spel-uchile/S2_S3_PS_MAG_PCBs/Grafeno V2/TG_SAT_24V0_V1.4-BOM.xlsx

 |  |  | TG_DEV-24V0-V1.4 PCS BOM
Item # | *Designator | *Qty | Manufacturer | *Mfg Part # | Description / Value | *Package/Footprint | Type | Your Instructions / Notes
1 | C7 | 1 | Taiyo Yuden | UMF107B7223KAHT | Capacitor, 0,022 uF, +/- 10%, 50V, X7R | 0603 | SMD
2 | C6 | 1 | Yageo | CC0603KRX7R8BB104 | Capacitor, 0,1 uF, +/- 10%, 25V, X7R | 0603 | SMD
3 | J3 | 1 | Molex | 532610841 | Connector 4 ways |  | SMD
4 | J9 | 1 | Molex | 532610871 | Connector 8 ways |  | SMD
5 | R30 | 1 | Yageo | RT0603BRC0710KL | Resistor, 10 kOhm, +/- 0.1%, 0.1W, +/- 15ppm/C° | 0603 | SMD
6 | RFB2 | 1 | Susumu | RG2012N-124-W-T1 | Resistor, 120 kOhm, +/- 0.05%, 0.125W, +/- 10 ppm/C | 0805 | SMD
7 | RG1 | 1 | Panasonic | ERA-8ARW1432V | Resistor, 14,3 kOhm, +/- 0.05%, 0.25W, +/- 10 ppm/C | 1206 | SMD
8 | RG2 | 1 | Panasonic | ERA-8ARW163V | Resistor, 16 kOhm, +/- 0.05%, 0.25W, +/- 10 ppm/C | 1206 | SMD
9 | RFB1 | 1 | KOA Speer | RN73H1JTTD1722B25 | Resistor, 17,2 kOhm, +/- 0.1%, 0.1W, +/-25 ppm/C° | 0603 | SMD
10 | R32 | 1 | Panasonic | ERA-3VRW1802V | Resistor, 18 kOhm, +/-0.05%, 0.1W, +/-10ppm/C° | 0603 | SMD
11 | C15 | 1 | Taiyo Yuden | UMK316B7225MLHT | Capacitor, 2,2 uF, +/-20%, 50V, Low ESR | 1206 | SMD
12 | R33 | 1 | Stackpole | RNCF0603TKY200R | Resistor, 200 Ohm, +/- 0.01%, 0.1W, +/-5 ppm/C° | 0603 | SMD
13 | C16 | 1 | TDK | C3216X5R1V226M160AC | Capacitor, 22 uF, +/- 20%, 35V, X5R | 1206 | SMD
14 | R34 | 1 | Panasonic | ERA-3ARW362V | Resistor, 3,6 kOhm, +/-0.05%, 0.1W, +/-10ppm/C° | 0603 | SMD
15 | R9 | 1 | Panasonic | ERA-3ARW432V | Resistor, 4,3 kOhm, +/- 0.05%, 0.25W, +/- 10 ppm/C | 0603 | SMD
16 | R29 | 1 | Vishay Thin film | PTN0805E9002BST1 | Resistor, 90 kOhm, +/. 0.1%, 0,2W, +/- 25ppm/C° | 0805 | SMD
17 | U3 | 1 | Analog Devices | ADA4522-1ARMZ | Opamp, , Zero-Drift opamp | 8-MSOP | SMD
18 | U2 | 1 | Texas Instruments | DAC7562SDGST | DAC, , 12 bit, 2 channels | 10VSSOP | SMD
19 | U4 | 1 | Maxim Integrated | MAX6175AASA+ | Voltage ref, 5 Volts, 30 mA, ± 0.06%, 3pm/C° | 8-SOIC | SMD
20 | U1 | 1 | CUI Inc | PES1-S5-D24-M-TR | DC-DC Converter, , +24/-24 V, 1W | 8-SMD | SMD
21 | U12 | 1 | Texas Instruments | REF5025IDR | Voltage reference, 2,5 Volts, +/- 0.05%, 10mA, 3 ppm/C° | 8-SOIC | SMD
22 | C21, C38 | 2 | Murata Electronics | GRM188R61E106KA73J | Capacitor, 10 uF, +/- 10%, 25V, X5R | 0603 | SMD
23 | U16, U17 | 2 | Microchip Technology | 24LC1025T-E/SN | EEPROM, 1 Mbit, 1 Mbit, I2C | SOIC-8 | SMD
24 | C1, C5 | 2 | Taiyo Yuden | UMK316ABJ475MLHT | Capacitor, 4,7 uF, +/- 20%, 50V, X5R, Ultra Low ESR | 1206 | SMD
25 | U6, U15 | 2 | Texas Instruments | ADS7951QDBTRQ1 | Analog to Digital Conv, , 12 bit, SAR, 8 input | 30-TSSOP | SMD
26 | R20, R23, R24 | 3 | TE Connectivity | CRGCQ0603J47R | Resistor, 47 Ohm, 5%, 0.1W | 0603 | SMD
27 | U8, U10, U11 | 3 | Texas Instruments | TMP175AQDRQ1 | Temp sensor, , 12 bits | SOIC-8 | SMD
28 | C22, C26, C27, C28 | 4 | Yageo | CC0603FRNPO9BN151 | Capacitor, 150 pF, +/-1%, 50V | 0603 | SMD | DNP/DNI
29 | R39, R40, R41, R42 | 4 | Yageo | RT0603DRD072K74L | Resistor, 2,74 kOhm, +/- 0.5%, 0.1W, +/- 25ppm/C° | 0603 | SMD | DNP/DNI
30 | C8, C9, C12, C10, C23, C25, C39, C44 | 8 | DNP/DNI | DNP/DNI | DNP/DNI | DNP/DNI | DNP/DNI | DNP/DNI
31 | R6, R12, R36, R46, R50 | 5 | Panasonic | ERA-3AEB332V | Resistor, 3,3 kOhm, +/- 0.1%, 0.1W, +/-25ppm/C° | 0603 | SMD
32 | R5, R11, R35, R45, R49 | 5 | KOA Speer | RN732BTTD3203B25 | Resistor, 320 kOhm, +/- 0.1%, 0.125W, +/-25ppm/C° | 1206 | SMD
33 | R4, R8, R31, R38, R48 | 5 | Vishay | PAT0603E4000BST1 | Resistor SHUNT, 400 Ohm, +/- 0.1%, 0.15W, +/-25ppm/C° | 0603 | SMD
34 | U5, U7, U14, U18, U19 | 5 | Texas Instruments | OPA189IDBVR | Opamp, , Zero drift, Rail-to-rail | SOT23-5 | SMD
35 | C4, C11, C24, C36, C37, C43 | 6 | Taiyo Yuden | LMK212SD104KG-T | Capacitor, 0,1 uF, Low ESR, ± 10%, 10V | 0805 | SMD
36 | R1, R3, R10, R21, R22, R25, R26 | 7 | Stackpole | RNCP0805FTD10K0 | Resistor, 10 kOhm, +/- 1%, 0.25W, +/- 100ppm/C° | 0805 | SMD
37 | C2, C3, C33, C34, C35, C40, C41, C42 | 8 | Taiyo Yuden | GMK107BJ105MAHT | Capacitor, 1 uF, +/-20%, 35V, Low ESR | 0603 | SMD
38 | R2, R7, R13, R37, R47, R51, R14, R15, R27, R28 | 10 | Yageo | RC0603JR-070RL | Resistor, 0 Ohm, 1/10 W | 0603 | SMD
