spel-uchile/S2_S3_PS_MAG_PCBs/CADs/IGEs/PBES2_v4.igs

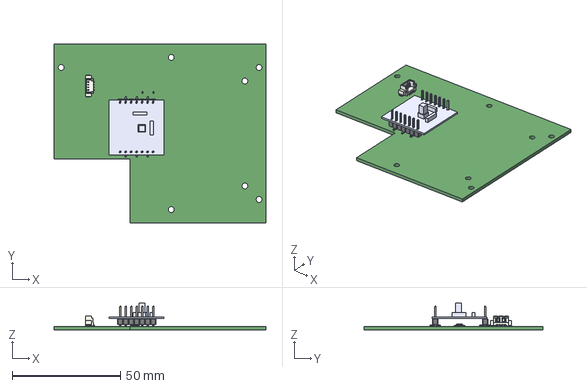
[picture p1: CAD file, 2022-08-22]
CADs/IGEs/PBES2_v4.igs
98.0 x 82.6 x 12.2 mm
