spel-uchile/S2_S3_PS_MAG_PCBs/CADs/Panel B I S3.step

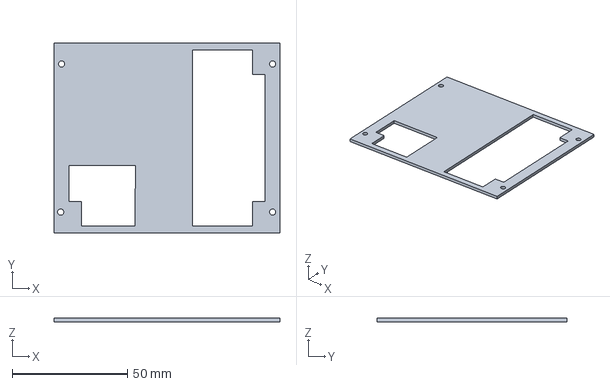
[picture p2: CAD file, 2022-08-22]
CADs/Panel B I S3.step
98.0 x 82.6 x 1.60 mm
