spel-uchile/S2_S3_PS_MAG_PCBs/mini_sensor/MAG_Plus/Panel A E S2.step

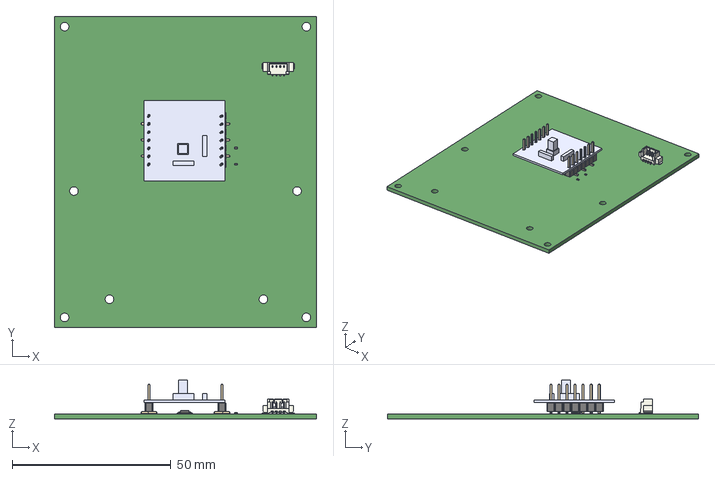
[picture p3: CAD file, 2022-08-22]
mini_sensor/MAG_Plus/Panel A E S2.step
82.6 x 98.0 x 12.2 mm
