spel-uchile/S2_S3_PS_MAG_PCBs/PAD/MAG_Plus/Panel A I S2.step

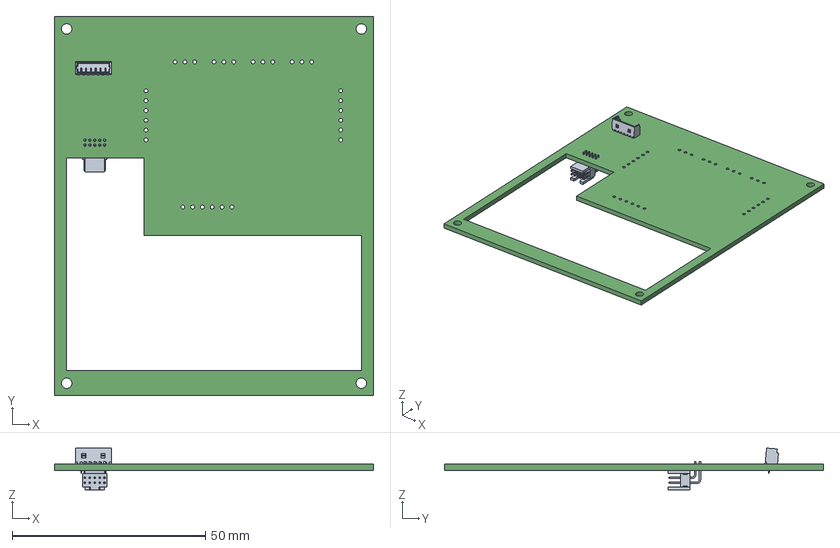
[picture p4: CAD file, 2022-08-22]
PAD/MAG_Plus/Panel A I S2.step
82.6 x 98.0 x 10.9 mm
