spel-uchile/S2_S3_PS_MAG_PCBs/panel test/MAG_Plus/MAG_mini.step

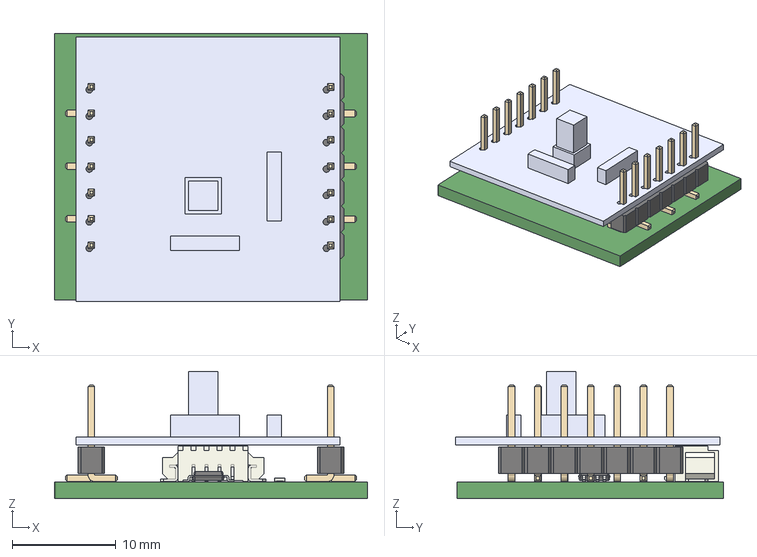
[picture p5: CAD file, 2022-08-22]
panel test/MAG_Plus/MAG_mini.step
30.1 x 25.7 x 12.2 mm
