spel-uchile/S2_S3_PS_MAG_PCBs/PC104 - plansat/MAG_plus/PC104_mini_chamber.dxf

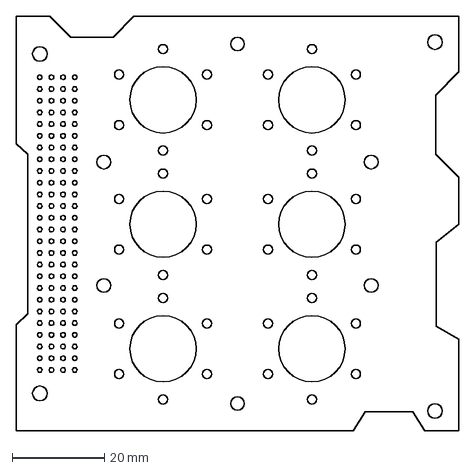
[picture p6: CAD file, 2022-08-22]
PC104 - plansat/MAG_plus/PC104_mini_chamber.dxf
96.0 x 89.9 mm
