spel-uchile/S2_S3_PS_MAG_PCBs/(list of files, cad)

Other CAD files:
Panel A E S3/MAG_Plus/Panel A E S3.step
Panel A I S3/MAG_Plus/Panel A I S3.step
Panel B E S2/MAG_Plus/Panel B E S2.step
Panel B E S3 - plantsat/MAG_Plus/Panel B E S3.step
Panel B E S3/MAG_Plus/Panel B E S3.step
Panel B I S2/MAG_Plus/Panel B I S2.step
Panel B I S3 PC/MAG_Plus/Panel B I S3.step
Panel B I S3/MAG_Plus/Panel B I S3.step
PBD/MAG_Plus/Panel B I S2.step
CADs/IGEs/PBES2.igs
CADs/Panel B E S2.step
CADs/IGEs/PAES2_v3.igs
CADs/Panel A E S2.step
CADs/IGEs/PBIS3.igs
CADs/Panel B E S3.step
CADs/IGEs/PAIS3.igs
CADs/Panel A E S3.step
CADs/IGEs/PBES3.igs
CADs/Panel A I S3.step
CADs/IGEs/PAES2.igs
CADs/IGEs/PAIS2.igs
CADs/IGEs/PBES3_v2.igs
CADs/IGEs/PAES3.igs
CADs/IGEs/PBIS2_v2.igs
CADs/IGEs/PBIS3_v2.igs
CADs/IGEs/PBIS2.igs
CADs/IGEs/PAES2_v2.igs
CADs/IGEs/PBES2_v2.igs
CADs/IGEs/PBES2_v3.igs
