spel-uchile/S2_S3_PS_MAG_PCBs/PC104 main/MAG_Plus/MAG_Plus.kicad_pcb

## KiCad design PC104 main/MAG_Plus/MAG_Plus.kicad_pcb (2022-08-22)

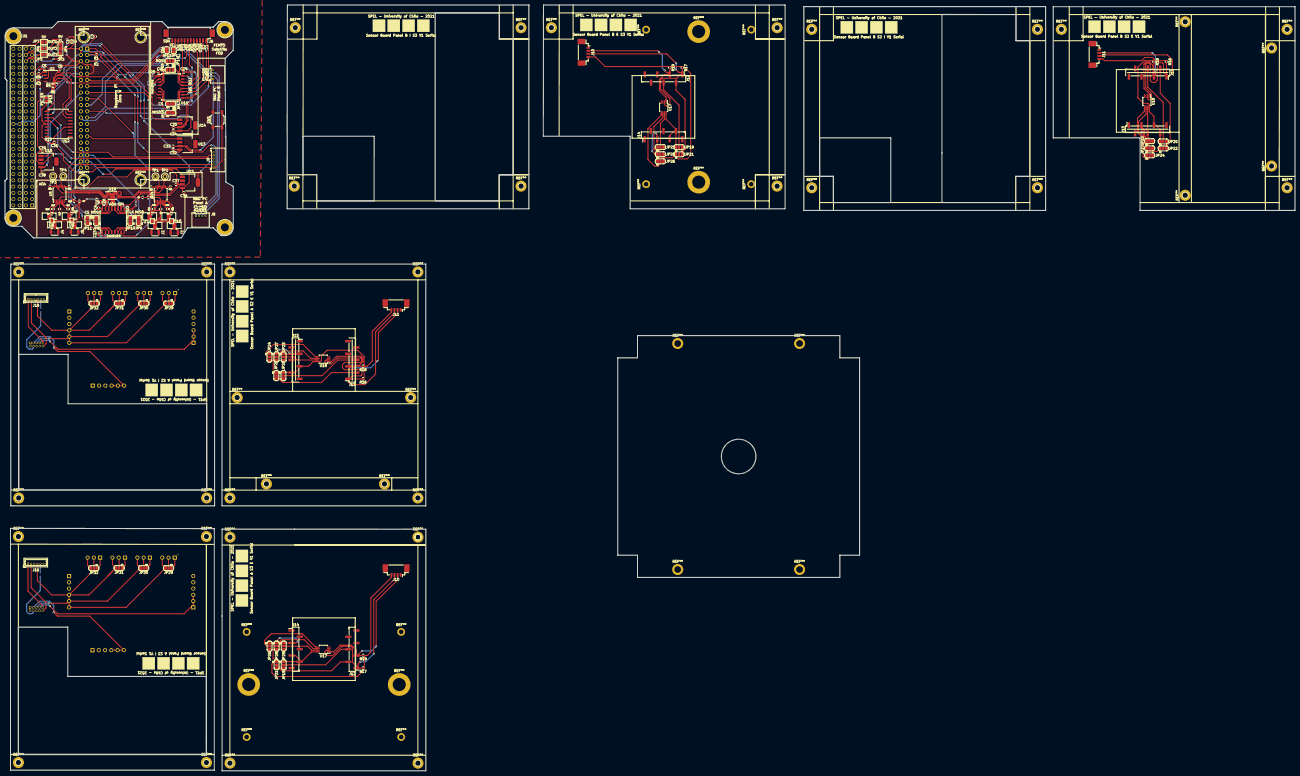
[picture p12: board PC104 main/MAG_Plus/MAG_Plus.kicad_pcb from above]

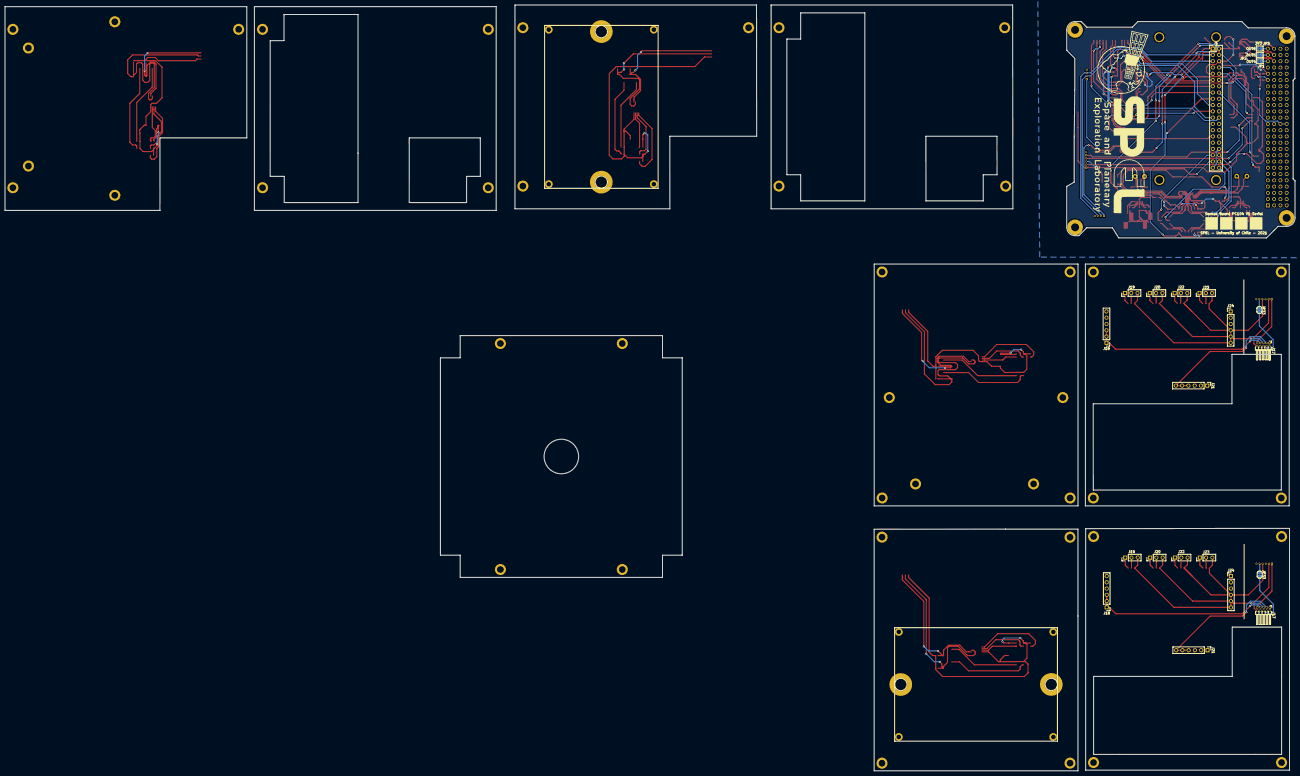
[picture p13: board PC104 main/MAG_Plus/MAG_Plus.kicad_pcb from below]

Board: 2 copper layers, 522.8 x 310.4 mm, 169 parts (22 on the bottom side), 123 nets.

Parts:
C1, C2, C3, C4, C5, C6, C23, C24, C25, C26, C27, C31, C32, C33, C34, C35, C36, C37, C38, C39: C; C_0402
C7, C8, C9, C10, C11, C12, C13, C14, C15, C16, C17, C18, C19, C20, C21, C22: C_Small; C_0402
J1: RPi_GPIO; Pin_Header_Straight_2x20_Pitch2.54mm
J2, J3, J4, J5: U.FL-R-SMT(01); U.FL_Hirose_U.FL-R-SMT-1_Vertical
J6: Conn_01x12_Male; Molex_PicoBlade_53261-1271_12x1.25mm_Angled
J7, J8: Conn_01x04_Male; Molex_PicoBlade_53048-0410_04x1.25mm_Angled
J9: Conn_01x06_Male; Molex_PicoBlade_53048-0610_06x1.25mm_Angled
J10, J10#2, J11, J11#2: Conn_01x04_Male; Molex_PicoBlade_53398-0471_04x1.25mm_Straight
J12, J12#2, J14, J14#2: Conn_01x07_Female; Pin_Header_Straight_1x07_Pitch2.54mm_SMD_Pin1Left
J13, J13#2, J15, J15#2: Conn_01x07_Female; Pin_Header_Straight_1x07_Pitch2.54mm_SMD_Pin1Right
J16, J16#2: Conn_01x06_Male; Molex_PicoBlade_53047-0610_06x1.25mm_Straight
J17, J17#2: Conn_02x05_Counter_Clockwise; Pin_Header_Angled_2x05_Pitch1.27mm
J18, J18#2, J21, J21#2, J24, J24#2: Conn_01x06_Male; Pin_Header_Straight_1x06_Pitch2.54mm
J19, J19#2, J20, J20#2, J22, J22#2, J23, J23#2: Conn_01x03_Male; Pin_Header_Straight_1x03_Pitch2.54mm
JP1, JP2, JP3, JP5, JP6, JP7: Jumper_2_Open; SolderJumper-2_P1.3mm_Open_TrianglePad1.0x1.5mm
JP4: Jumper_3_Open; SolderJumper-3_P2.0mm_Open_TrianglePad1.0x1.5mm_NumberLabels
JP8, JP9, JP10, JP11, JP14, JP15, JP16, JP17, JP19, JP19#2, JP20, JP20#2, JP21, JP21#2, JP22, JP22#2, JP23, JP23#2, JP24, JP24#2, JP25, JP25#2, JP26, JP26#2, JP27, JP27#2, JP28, JP28#2, JP29, JP29#2, JP30, JP30#2, JP31, JP31#2, JP32, JP32#2: Jumper_3_Open; SolderJumper-3_P1.3mm_Open_RoundedPad1.0x1.5mm
JP12, JP13, JP33, JP33#2: Jumper_2_Open; SolderJumper-2_P1.3mm_Open_RoundedPad1.0x1.5mm
JP18: Jumper_2_Open; SolderJumper-2_P1.3mm_Open_Pad1.0x1.5mm
R1, R2, R3, R4, R5, R6, R15, R16, R16#2, R17, R17#2, R18, R18#2, R19, R19#2: R; R_0402
R7, R8, R9, R10, R11, R13: R_Small; R_0402
SW1: SW_Push; SW_SPST_SKQG
TP1, TP2, TP3, TP4: TestPoint; Test_Point_Keystone_5000-5004_Miniature
U1: Payload; PC104-Standard
U2: ISO1540; SOIC-8_3.9x4.9mm_Pitch1.27mm
U3, U11: ISO7341C; SOIC-16W_7.5x10.3mm_Pitch1.27mm
U4, U5: AD8302; TSSOP-14_4.4x5mm_Pitch0.65mm
U7, U8, U9, U10: QPQ1906SR
U12: PIC16F1847-I_SO; SOIC-18W_7.5x11.6mm_Pitch1.27mm
U13, U14, U16: LP38693MP-3.3; SOT-223-5
U15: LP38693MP-5.0; SOT-223-5
U17, U17#2, U18, U18#2: MCP9804_MSOP; MSOP-8_3x3mm_Pitch0.65mm
U19: ADC084S051; MSOP-10_3x3mm_Pitch0.5mm

Connections:
3V3IN: JP1.2, JP2.2, JP3.2, JP4.1
5VIN: JP4.3, JP5.2, JP6.2, JP7.2
ANT1_IN: J2.1, U7.1
ANT1_OUT: C11.1, R7.1, U7.2
ANT2_IN: J3.1, U10.1
ANT2_OUT: C14.1, R8.2, U10.2
ANT3_IN: J4.1, U8.1
ANT3_OUT: C15.1, R9.1, U8.2
ANT4_IN: J5.1, U9.1
ANT4_OUT: C18.1, R10.2, U9.2
AOA_5V: C4.1, C7.2, C9.2, C26.1, C27.1, C37.1, R11.1, R13.1, U3.10, U3.16, U15.3, U19.2
AOA_CLK: JP10.3, U3.12, U19.10
AOA_EN: J1.37, U15.1
AOA_MISO: JP9.3, U3.11, U19.9
AOA_MOSI: JP8.3, U3.13, U19.8
AOA_SS: JP11.3, U3.14, U19.1
CLK0: J1.23, JP16.2
CLK1: J1.40, JP10.2
CSP_SCL: R4.2, U1.43, U2.3
CSP_SDA: R3.2, U1.41, U2.2
ENN: J20.2, J20#2.2, JP30.2, JP30#2.2
ENP: J23.2, J23#2.2, JP32.2, JP32#2.2
FOD_3V3: C24.1, C35.1, J6.7, J6.10, U11.10, U11.16, U14.3
FOD_CC: J1.15, J6.1
FOD_CS: J6.2, JP17.3, U11.12
FOD_DPL: J1.11, J6.8
FOD_EN: J1.13, U14.1
FOD_MISO: J6.3, JP15.3, U11.11
FOD_MOSI: J6.5, JP14.3, U11.14
FOD_SCK: J6.4, JP16.3, U11.13
FOD_SCL: J6.11, JP12.2
FOD_SDA: J6.12, JP13.2
GND: C1.2, C2.2, C3.2, C4.2, C5.2, C6.2, C7.1, C8.1, C9.1, C10.1, C12.1, C13.1, C16.1, C17.1, C19.2, C20.2, C21.2, C22.2, C23.2, C24.2, C25.2, C26.2, C27.2, C31.1, C32.2, C33.2, C34.2, C35.2, C36.2, C37.2, C38.2, C39.2, J1.6, J1.9, J1.14, J1.20, J1.25, J1.30, J1.34, J1.39, J2.2, J3.2, J4.2, J5.2, J6.6, J6.9, J7.4, J8.4, J9.3, J10.1, J10#2.1, J11.1, J11#2.1, J12.7, J12#2.7, J13.7, J13#2.7, J14.7, J14#2.7, J15.7, J15#2.7, J16.3, J16#2.3, J17.6, J17#2.6, J18.4, J18.5, J18.6, J18#2.4, J18#2.5, J18#2.6, J19.1, J19#2.1, J20.1, J20#2.1, J21.1, J21.2, J21.3, J21#2.1, J21#2.2, J21#2.3, J22.1, J22#2.1, J23.1, J23#2.1, J24.1, J24.2, J24.3, J24#2.1, J24#2.2, J24#2.3, JP19.3, JP19#2.3, JP20.3, JP20#2.3, JP21.3, JP21#2.3, JP22.3, JP22#2.3, JP23.3, JP23#2.3, JP24.3, JP24#2.3, JP25.3, JP25#2.3, JP26.3, JP26#2.3, JP27.3, JP27#2.3, JP28.3, JP28#2.3, JP29.1, JP29#2.1, JP30.1, JP30#2.1, JP31.1, JP31#2.1, JP32.1, JP32#2.1, R7.2, R8.1, R9.2, R10.1, SW1.1, U2.4, U2.5, U3.2, U3.8, U3.9, U3.15, U4.1, U4.7, U5.1, U5.7, U7.3, U8.3, U9.3, U10.3, U11.2, U11.8, U11.9, U11.15, U12.5, U13.5, U14.5, U15.5, U16.5, U17.4, U17#2.4, U18.4, U18#2.4, U19.3
ICSPCLK: J9.5, U12.12
ICSPDAT: J9.4, U12.13
LPS_3V3: J16.5, J16#2.5, JP33.1, JP33#2.1
LPS_3V3J: J17.4, J17#2.4, JP33.2, JP33#2.2
LPS_5V: J16.4, J16#2.4, J17.5, J17#2.5, J19.3, J19#2.3, J20.3, J20#2.3, J22.3, J22#2.3, J23.3, J23#2.3, J24.4, J24.5, J24.6, J24#2.4, J24#2.5, J24#2.6, JP29.3, JP29#2.3, JP30.3, JP30#2.3, JP31.3, JP31#2.3, JP32.3, JP32#2.3
LPS_RX: J16.1, J16#2.1, J17.9, J17#2.9
LPS_TX: J16.2, J16#2.2, J17.10, J17#2.10
MAG1_A0: JP25.2, JP25#2.2, U17.7, U17#2.7
MAG1_A1: JP28.2, JP28#2.2, U17.6, U17#2.6
MAG1_A2: JP26.2, JP26#2.2, U17.5, U17#2.5
MAG1_BIT0: J12.4, J12#2.4, JP19.2, JP19#2.2
MAG1_BIT1: J12.2, J12#2.2, JP21.2, JP21#2.2
MAG2_A0: JP23.2, JP23#2.2, U18.7, U18#2.7
MAG2_A1: JP27.2, JP27#2.2, U18.6, U18#2.6
MAG2_A2: JP24.2, JP24#2.2, U18.5, U18#2.5
MAG2_BIT0: J13.4, J13#2.4, JP20.2, JP20#2.2
MAG2_BIT1: J13.2, J13#2.2, JP22.2, JP22#2.2
MAG_3V3: C33.1, J7.1, J8.1, J10.4, J10#2.4, J11.4, J11#2.4, J14.3, J14.5, J14.6, J14#2.3, J14#2.5, J14#2.6, J15.3, J15.5, J15.6, J15#2.3, J15#2.5, J15#2.6, JP19.1, JP19#2.1, JP20.1, JP20#2.1, JP21.1, JP21#2.1, JP22.1, JP22#2.1, JP23.1, JP23#2.1, JP24.1, JP24#2.1, JP25.1, JP25#2.1, JP26.1, JP26#2.1, JP27.1, JP27#2.1, JP28.1, JP28#2.1, R16.1, R16#2.1, R17.1, R17#2.1, R18.1, R18#2.1, R19.1, R19#2.1, U13.3, U17.8, U17#2.8, U18.8, U18#2.8
MAG_EN: J1.29, U13.1
MCLR: C31.2, J9.1, R15.2, SW1.2, U12.4
MISO0: J1.21, JP15.2
MISO1: J1.35, JP9.2
MOSI0: J1.19, JP14.2
MOSI1: J1.38, JP8.2
unnamed: C8.2, R11.2, U4.4
unnamed: C10.2, R13.2, U5.4
unnamed: C11.2, U4.2
unnamed: C12.2, U4.3
unnamed: C13.2, U4.5
unnamed: C14.2, U4.6
unnamed: C15.2, U5.2
unnamed: C16.2, U5.3
unnamed: C17.2, U5.5
unnamed: C18.2, U5.6
unnamed: C19.1, U4.14
unnamed: C20.1, U4.8
unnamed: C21.1, U5.14
unnamed: C22.1, U5.8
unnamed: J12.5, J12#2.5
unnamed: J12.6, J12#2.6
unnamed: J13.5, J13#2.5
unnamed: J13.6, J13#2.6
unnamed: J14.1, J14#2.1
unnamed: J14.2, J14#2.2
unnamed: J14.4, J14#2.4
unnamed: J15.1, J15#2.1
unnamed: J15.2, J15#2.2
unnamed: J15.4, J15#2.4
unnamed: J16.6, J16#2.6
unnamed: J17.1, J17#2.1
unnamed: J17.2, J17#2.2
unnamed: J17.8, J17#2.8
unnamed: U17.3, U17#2.3
unnamed: U18.3, U18#2.3
OUT1_3V3: JP1.1, U1.47
OUT2_3V3: JP2.1, U1.49
OUT3_3V3: JP3.1, U1.51
OUT4_5V0: JP5.1, U1.48
OUT5_5V0: JP6.1, U1.50
OUT6_5V0: JP7.1, U1.52
PIC_3V3: C39.1, J9.2, JP18.1, U16.3
PIC_3V3J: C6.1, JP18.2, R5.1, R6.1, R15.1, U2.8, U12.14
PIC_EN: J1.16, U16.1
PIC_SCL: JP12.1, R6.2, U2.6, U12.10
PIC_SDA: JP13.1, R5.2, U2.7, U12.7
PSN: J19.2, J19#2.2, JP29.2, JP29#2.2
PSP: J22.2, J22#2.2, JP31.2, JP31#2.2
RPI_3V3: C3.1, C23.1, C25.1, J1.1, J1.17, R1.1, R2.1, U3.1, U3.7, U11.1, U11.7
RPI_RX: J1.10, U12.11
RPI_SCL: J1.5, J7.2, J8.2, J10.3, J10#2.3, J11.3, J11#2.3, J12.1, J12#2.1, J13.1, J13#2.1, R2.2, R16.2, R16#2.2, R17.2, R17#2.2, U17.2, U17#2.2, U18.2, U18#2.2
RPI_SDA: J1.3, J7.3, J8.3, J10.2, J10#2.2, J11.2, J11#2.2, J12.3, J12#2.3, J13.3, J13#2.3, R1.2, R18.2, R18#2.2, R19.2, R19#2.2, U17.1, U17#2.1, U18.1, U18#2.1
RPI_TX: J1.8, U12.8
SAT_3V3: C5.1, R3.1, R4.1, U1.79, U1.80, U2.1
SS00: J1.24, JP17.2
SS10: J1.36, JP11.2
VIN: C1.1, C2.1, C32.1, C34.1, C36.1, C38.1, J1.2, J1.4, JP4.2, U13.4, U14.4, U15.4, U16.4
VMAG1: TP1.1, U4.12, U4.13, U19.7
VMAG2: TP3.1, U5.12, U5.13, U19.5
VNEG: J17.7, J17#2.7, J18.1, J18.2, J18.3, J18#2.1, J18#2.2, J18#2.3
VPHS1: TP2.1, U4.9, U4.10, U19.6
VPHS2: TP4.1, U5.9, U5.10, U19.4
VPOS: J17.3, J17#2.3, J21.4, J21.5, J21.6, J21#2.4, J21#2.5, J21#2.6
iaRPI_CLK: JP10.1, U3.5
iaRPI_MISO: JP9.1, U3.6
iaRPI_MOSI: JP8.1, U3.4
iaRPI_SS0: JP11.1, U3.3
ifRPI_CLK: JP16.1, U11.4
ifRPI_MISO: JP15.1, U11.6
ifRPI_MOSI: JP14.1, U11.3
ifRPI_SS0: JP17.1, U11.5
