spel-uchile/S2_S3_PS_MAG_PCBs/Panel B E S3/MAG_Plus/MAG_Plus.kicad_pcb

## KiCad design Panel B E S3/MAG_Plus/MAG_Plus.kicad_pcb (2022-08-22)

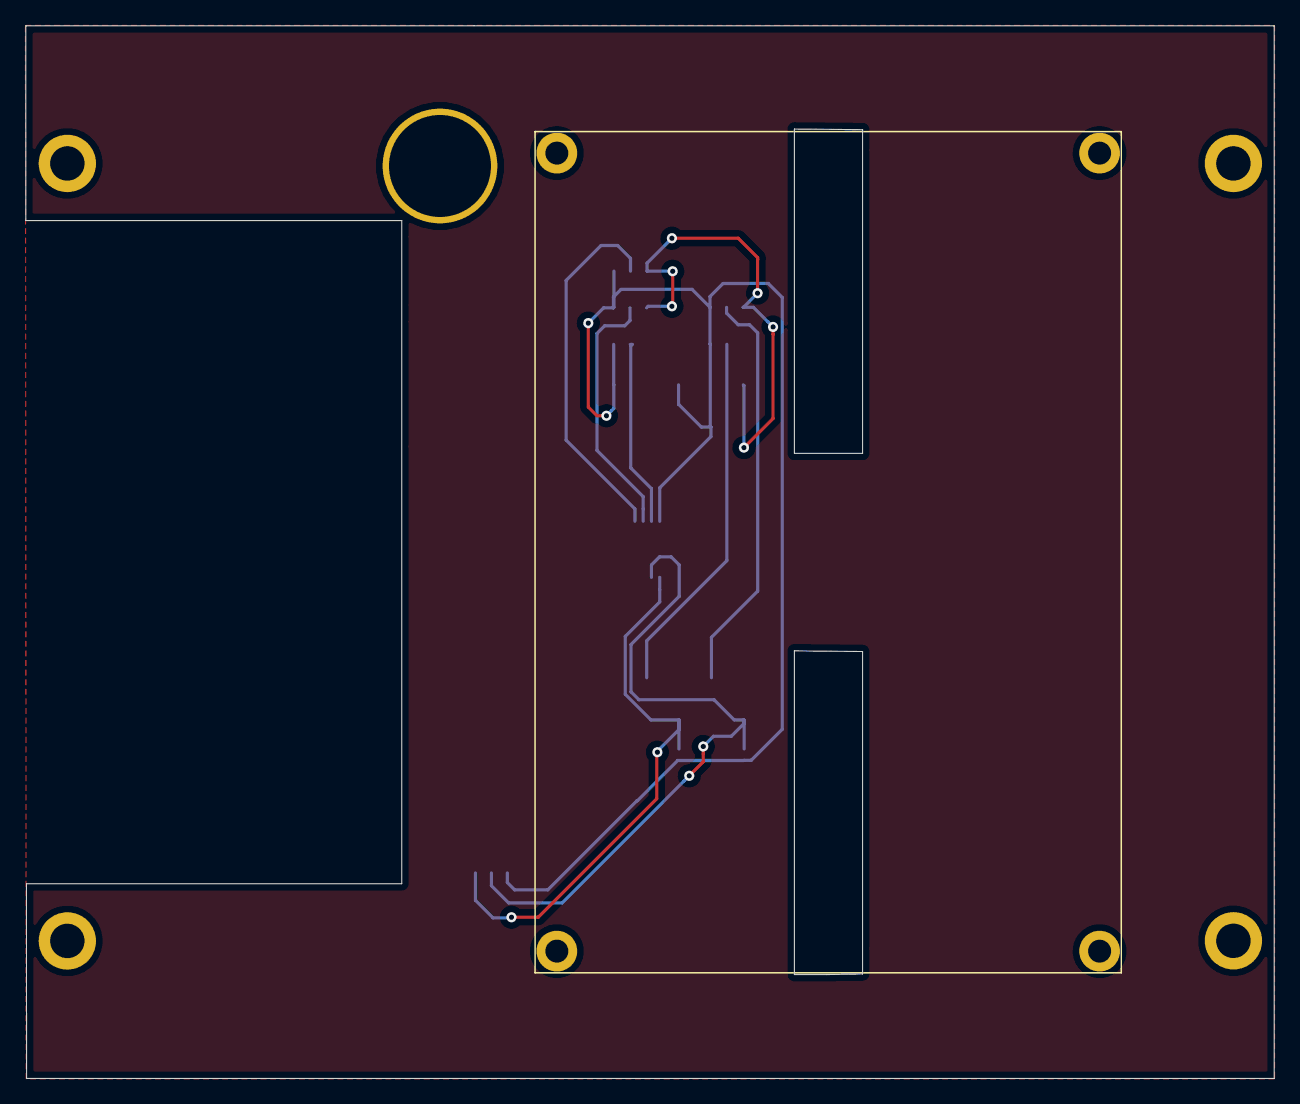
[picture p14: board Panel B E S3/MAG_Plus/MAG_Plus.kicad_pcb from above]

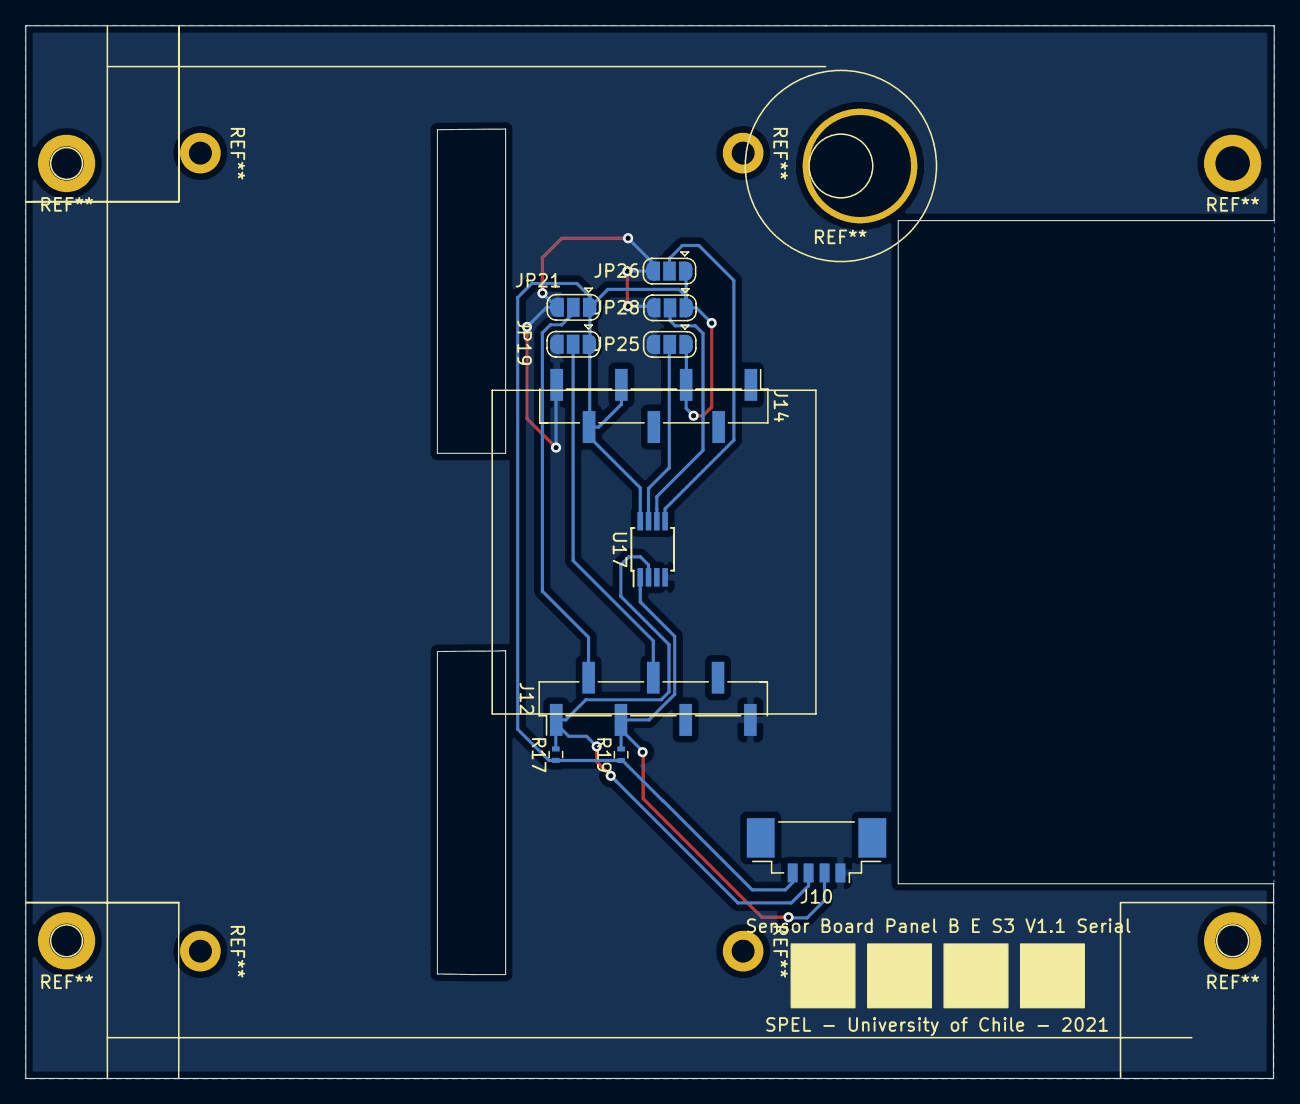
[picture p15: board Panel B E S3/MAG_Plus/MAG_Plus.kicad_pcb from below]

Board: 2 copper layers, 98.0 x 82.6 mm, 11 parts (11 on the bottom side), 9 nets.

Parts:
J10: Conn_01x04_Male; Molex_PicoBlade_53398-0471_04x1.25mm_Straight
J12, J14: Conn_01x07_Female; Pin_Header_Straight_1x07_Pitch2.54mm_SMD_Pin1Left
JP19, JP21, JP25, JP26, JP28: Jumper_3_Open; SolderJumper-3_P1.3mm_Open_RoundedPad1.0x1.5mm
R17, R19: R; R_0402
U17: MCP9804_MSOP; MSOP-8_3x3mm_Pitch0.65mm

Connections:
GND: J10.1, J12.7, J14.7, JP19.3, JP21.3, JP25.3, JP26.3, JP28.3, U17.4
MAG1_A0: JP25.2, U17.7
MAG1_A1: JP28.2, U17.6
MAG1_A2: JP26.2, U17.5
MAG1_BIT0: J12.4, JP19.2
MAG1_BIT1: J12.2, JP21.2
MAG_3V3: J10.4, J14.3, J14.5, J14.6, JP19.1, JP21.1, JP25.1, JP26.1, JP28.1, R17.1, R19.1, U17.8
RPI_SCL: J10.3, J12.1, R17.2, U17.2
RPI_SDA: J10.2, J12.3, R19.2, U17.1
