spel-uchile/S2_S3_PS_MAG_PCBs/PC104 _V3P2/MAG_Plus/MAG_Plus.kicad_pcb

## KiCad design PC104 _V3P2/MAG_Plus/MAG_Plus.kicad_pcb (2022-08-22)

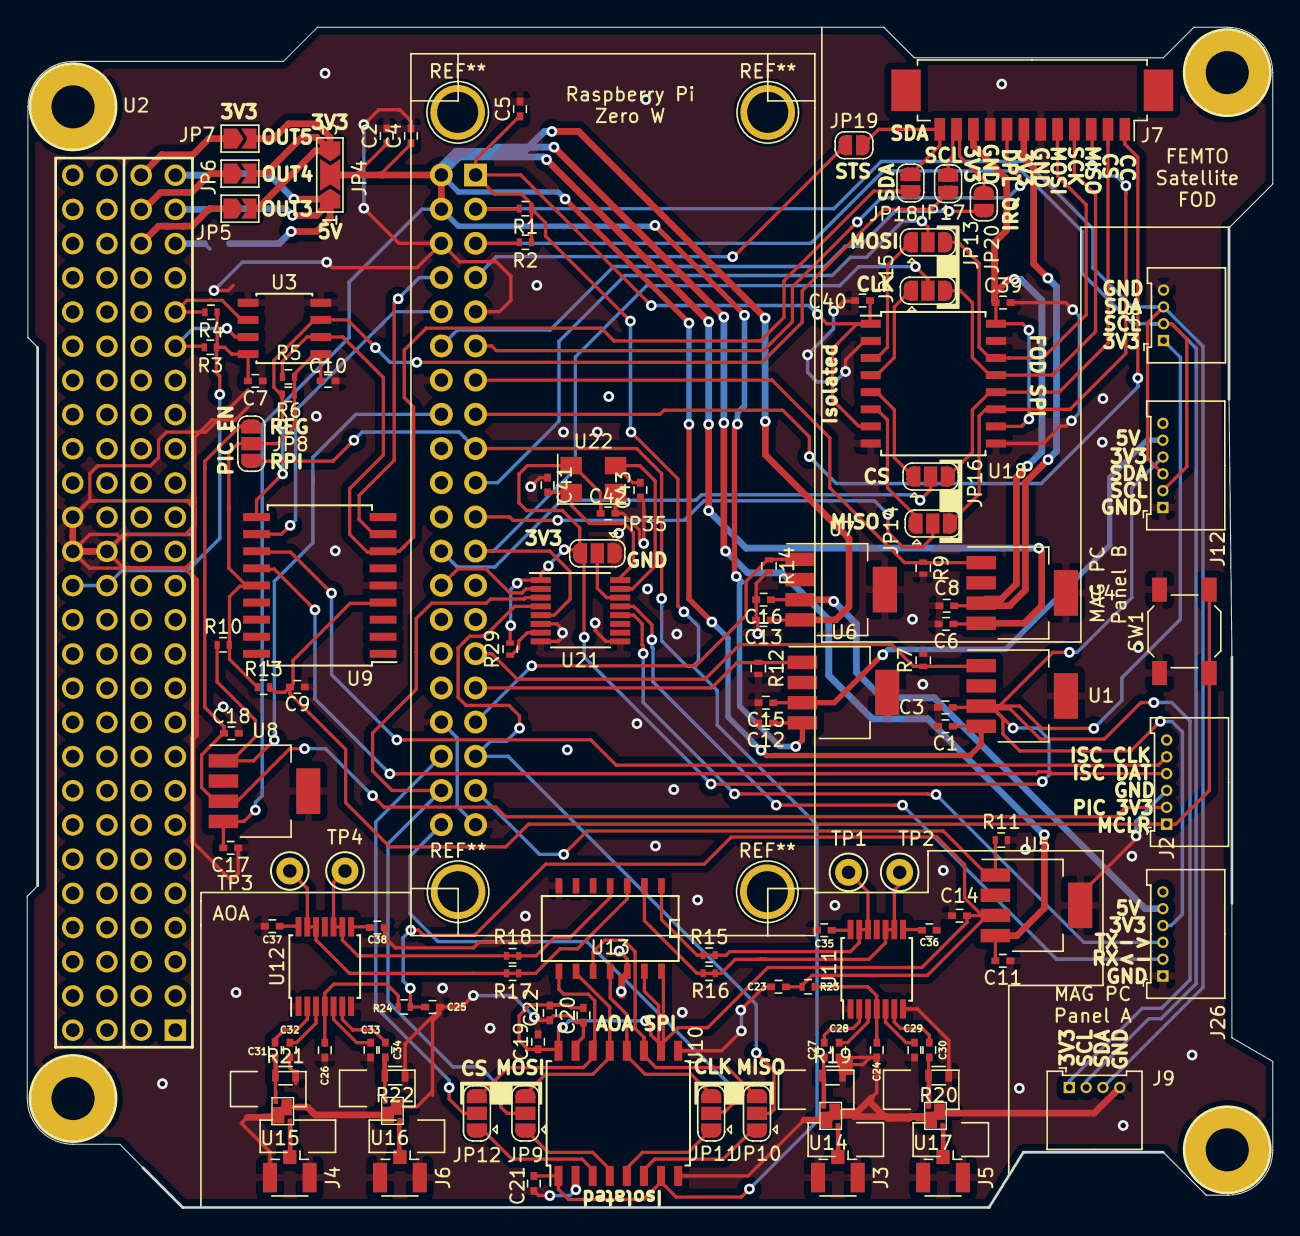
[picture p16: board PC104 _V3P2/MAG_Plus/MAG_Plus.kicad_pcb from above]

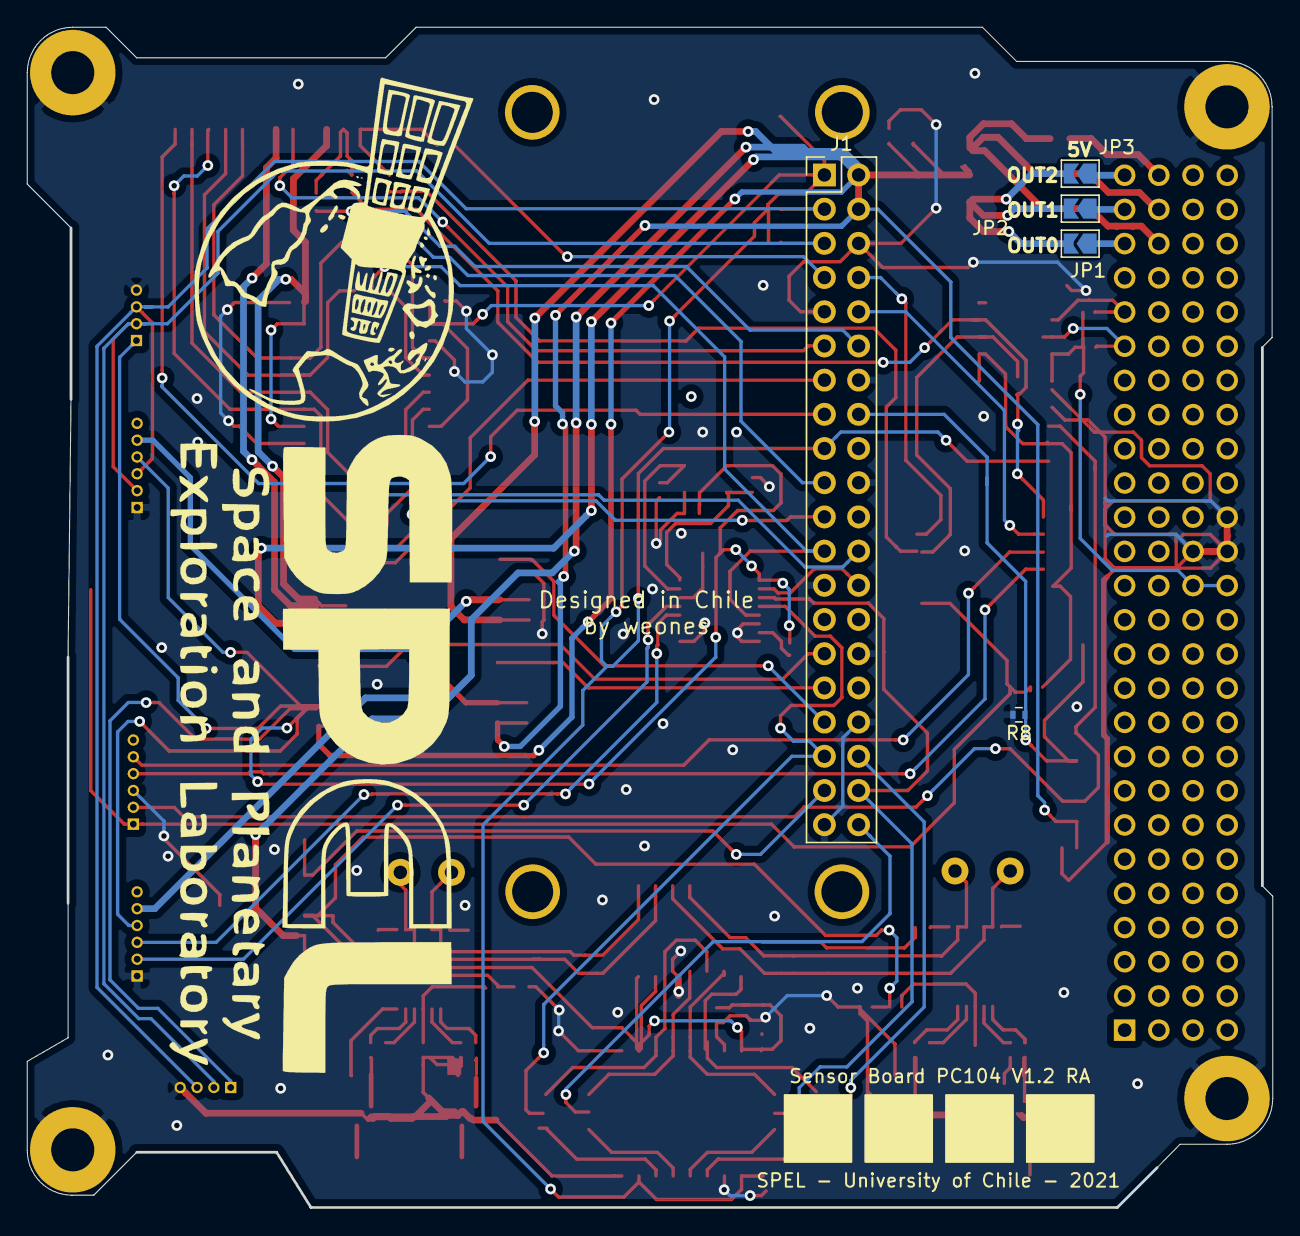
[picture p17: board PC104 _V3P2/MAG_Plus/MAG_Plus.kicad_pcb from below]

Board: 2 copper layers, 92.5 x 87.7 mm, 125 parts (5 on the bottom side), 99 nets.

Parts:
C1, C2, C3, C4, C5, C6, C7, C8, C9, C10, C11, C12, C13, C14, C15, C16, C17, C18, C19, C20, C21, C22, C39, C40, C42: C; C_0402
C23, C24, C25, C26, C27, C28, C29, C30, C31, C32, C33, C34, C35, C36, C37, C38: C_Small; C_0402
C41, C43: 15pF; C_0402
J1: RPi_GPIO; Pin_Header_Straight_2x20_Pitch2.54mm
J2, J12, J26: Conn_01x06_Male; Molex_PicoBlade_53048-0610_06x1.25mm_Angled
J3, J4, J5, J6: U.FL-R-SMT(01); U.FL_Hirose_U.FL-R-SMT-1_Vertical
J7: Conn_01x12_Male; Molex_PicoBlade_53261-1271_12x1.25mm_Angled
J8, J9: Conn_01x04_Male; Molex_PicoBlade_53048-0410_04x1.25mm_Angled
JP1, JP2, JP3, JP5, JP6, JP7: Jumper_2_Open; SolderJumper-2_P1.3mm_Open_TrianglePad1.0x1.5mm
JP4: Jumper_3_Open; SolderJumper-3_P2.0mm_Open_TrianglePad1.0x1.5mm_NumberLabels
JP8, JP9, JP10, JP11, JP12, JP13, JP14, JP15, JP16: Jumper_3_Open; SolderJumper-3_P1.3mm_Open_RoundedPad1.0x1.5mm
JP17, JP18, JP19, JP20: Jumper_2_Open; SolderJumper-2_P1.3mm_Open_RoundedPad1.0x1.5mm
JP35: SolderJumper_3_Open; SolderJumper-3_P1.3mm_Open_RoundedPad1.0x1.5mm
R1, R2, R3, R4, R5, R6, R7, R8, R9, R10, R11, R12, R13, R14, R15, R16, R17, R18, R29: R; R_0402
R19, R20, R21, R22: R_Small; R_0603
R23, R24: R_Small; R_0402
SW1: SW_Push; SW_SPST_SKQG
TP1, TP2, TP3, TP4: TestPoint; Test_Point_Keystone_5000-5004_Miniature
U1, U4, U8: LP38693MP-3.3; SOT-223-5
U2: Payload; PC104-Standard
U3: ISO1540; SOIC-8_3.9x4.9mm_Pitch1.27mm
U5, U6, U7: LP38693MP-5.0; SOT-223-5
U9: PIC16F1847-I_SO; SOIC-18W_7.5x11.6mm_Pitch1.27mm
U10, U18: ISO7341C; SOIC-16W_7.5x10.3mm_Pitch1.27mm
U11, U12: AD8302; TSSOP-14_4.4x5mm_Pitch0.65mm
U13: MCP3204; SOIC-14_N
U14, U15, U16, U17: QPQ1906SR; QPQ1906SR3
U21: SC16IS741AIPWJ; TSSOP-16_4.4x5mm_Pitch0.65mm
U22: Xtal; Crystal_SMD_5032-4pin_5.0x3.2mm

Connections:
3V3IN: JP1.2, JP2.2, JP3.2, JP4.1
5VIN: JP4.3, JP5.2, JP6.2, JP7.2
ANT1_IN: J3.1, U14.1
ANT1_OUT: C27.1, R19.1, U14.2
ANT2_IN: J5.1, U17.1
ANT2_OUT: C30.1, R20.2, U17.2
ANT3_IN: J4.1, U15.1
ANT3_OUT: C31.1, R21.1, U15.2
ANT4_IN: J6.1, U16.1
ANT4_OUT: C34.1, R22.2, U16.2
AOA_5V: C14.1, C19.1, C20.1, C22.1, C23.2, C25.2, R23.1, R24.1, U5.3, U10.10, U10.16, U13.13, U13.14
AOA_CLK: JP11.3, U10.12, U13.11
AOA_EN: J1.37, R11.1, U5.1
AOA_MISO: JP10.3, U10.11, U13.10
AOA_MOSI: JP9.3, U10.13, U13.9
AOA_SS: JP12.3, U10.14, U13.8
CLK0: J1.23, JP15.2, U21.5
CLK1: J1.40, JP11.2
CSP_SCL: R4.2, U2.43, U3.6
CSP_SDA: R3.2, U2.41, U3.7
FOD_3V3: C8.1, C39.1, J7.7, J7.10, U4.3, U18.10, U18.16
FOD_CC: J1.15, J7.1
FOD_CS: J7.2, JP16.3, U18.12
FOD_DPL: J1.11, J7.8
FOD_EN: J1.13, R9.1, U4.1
FOD_IRQ: J1.12, JP20.1
FOD_MISO: J7.3, JP14.3, U18.11
FOD_MOSI: J7.5, JP13.3, U18.14
FOD_SCK: J7.4, JP15.3, U18.13
FOD_SCL: J7.11, JP17.2, JP20.2
FOD_SDA: J7.12, JP18.2, JP19.2
FOD_STS: J1.7, JP19.1
GND: C1.2, C2.2, C3.2, C4.2, C5.2, C6.2, C7.2, C8.2, C9.1, C10.2, C11.2, C12.2, C13.2, C14.2, C15.2, C16.2, C17.2, C18.2, C19.2, C20.2, C21.2, C22.2, C23.1, C24.1, C25.1, C26.1, C28.1, C29.1, C32.1, C33.1, C35.2, C36.2, C37.2, C38.2, C39.2, C40.2, C41.1, C42.2, C43.1, J1.6, J1.9, J1.14, J1.20, J1.25, J1.30, J1.34, J1.39, J2.3, J3.2, J4.2, J5.2, J6.2, J7.6, J7.9, J8.4, J9.4, J12.1, J26.1, JP35.1, R7.2, R8.2, R9.2, R11.2, R12.2, R14.2, R19.2, R20.1, R21.2, R22.1, SW1.1, U1.5, U2.81, U2.82, U2.84, U3.4, U3.5, U4.5, U5.5, U6.5, U7.5, U8.5, U9.5, U10.2, U10.8, U10.9, U10.15, U11.1, U11.7, U12.1, U12.7, U13.7, U13.12, U14.3, U15.3, U16.3, U17.3, U18.2, U18.8, U18.9, U18.15, U21.6, U21.8, U21.9, U22.2
ICSPCLK: J2.5, U9.12
ICSPDAT: J2.4, U9.13
IRQ: R29.1, U21.7
LP_5V: C16.1, J26.5, U7.3
LP_EN: J1.33, R14.1, U7.1
LP_RESET: JP35.2, U21.14
MAG_3V3: C3.1, C42.1, J8.1, J9.1, J12.4, J26.4, JP35.3, R29.2, U1.3, U21.1, U22.4
MAG_EN: J1.29, R7.1, U1.1
MCLR: C9.2, J2.1, R13.2, SW1.2, U9.4
MISO0: J1.21, JP14.2
MISO1: J1.35, JP10.2, U21.4
MOSI0: J1.19, JP13.2
MOSI1: J1.38, JP9.2, U21.3
unnamed: C24.2, R23.2, U11.4
unnamed: C26.2, R24.2, U12.4
unnamed: C27.2, U11.2
unnamed: C28.2, U11.3
unnamed: C29.2, U11.5
unnamed: C30.2, U11.6
unnamed: C31.2, U12.2
unnamed: C32.2, U12.3
unnamed: C33.2, U12.5
unnamed: C34.2, U12.6
unnamed: C35.1, U11.14
unnamed: C36.1, U11.8
unnamed: C37.1, U12.14
unnamed: C38.1, U12.8
OUT1_3V3: JP1.1, U2.47
OUT2_3V3: JP2.1, U2.49
OUT3_3V3: JP3.1, U2.51
OUT4_5V0: JP5.1, U2.48
OUT5_5V0: JP6.1, U2.50
OUT6_5V0: JP7.1, U2.52
PC_5V: C15.1, J12.5, U6.3
PC_EN: J1.31, R12.1, U6.1
PIC_3V3: C18.1, J2.2, JP8.1, U8.3
PIC_3V3J: C10.1, JP8.2, R5.1, R6.1, R10.2, R13.1, U3.1, U9.14
PIC_EN: J1.16, R8.1, R10.1, U8.1
PIC_SCL: JP17.1, R6.2, U3.3, U9.10
PIC_SDA: JP18.1, R5.2, U3.2, U9.7
RPI_3V3: C5.1, C21.1, C40.1, J1.1, J1.17, JP8.3, R1.1, R2.1, U10.1, U10.7, U18.1, U18.7
RPI_RX: J1.10, U9.11
RPI_SCL: J1.5, J8.2, J9.2, J12.2, R2.2
RPI_SDA: J1.3, J8.3, J9.3, J12.3, R1.2
RPI_TX: J1.8, U9.8
RX: J26.2, U21.13
SAT_3V3: C7.1, R3.1, R4.1, U2.79, U2.80, U3.8
SS00: J1.24, JP16.2
SS01: J1.26, U21.2
SS10: J1.36, JP12.2
TX: J26.3, U21.12
VIN: C1.1, C2.1, C4.1, C6.1, C11.1, C12.1, C13.1, C17.1, J1.2, J1.4, JP4.2, U1.4, U4.4, U5.4, U6.4, U7.4, U8.4
VMAG1: R15.1, R15.2, TP1.1, U11.12, U11.13, U13.1
VMAG2: R17.1, R17.2, TP3.1, U12.12, U12.13, U13.3
VPHS1: R16.1, R16.2, TP2.1, U11.9, U11.10, U13.2
VPHS2: R18.1, R18.2, TP4.1, U12.9, U12.10, U13.4
XTAL1: C43.2, U22.3
XTAL2: C41.2, U22.1
iaRPI_CLK: JP11.1, U10.5
iaRPI_MISO: JP10.1, U10.6
iaRPI_MOSI: JP9.1, U10.4
iaRPI_SS0: JP12.1, U10.3
ifRPI_CLK: JP15.1, U18.4
ifRPI_MISO: JP14.1, U18.6
ifRPI_MOSI: JP13.1, U18.3
ifRPI_SS0: JP16.1, U18.5
