spel-uchile/S2_S3_PS_MAG_PCBs/PAD/MAG_Plus/MAG_Plus.kicad_pcb

## KiCad design PAD/MAG_Plus/MAG_Plus.kicad_pcb (2022-08-22)

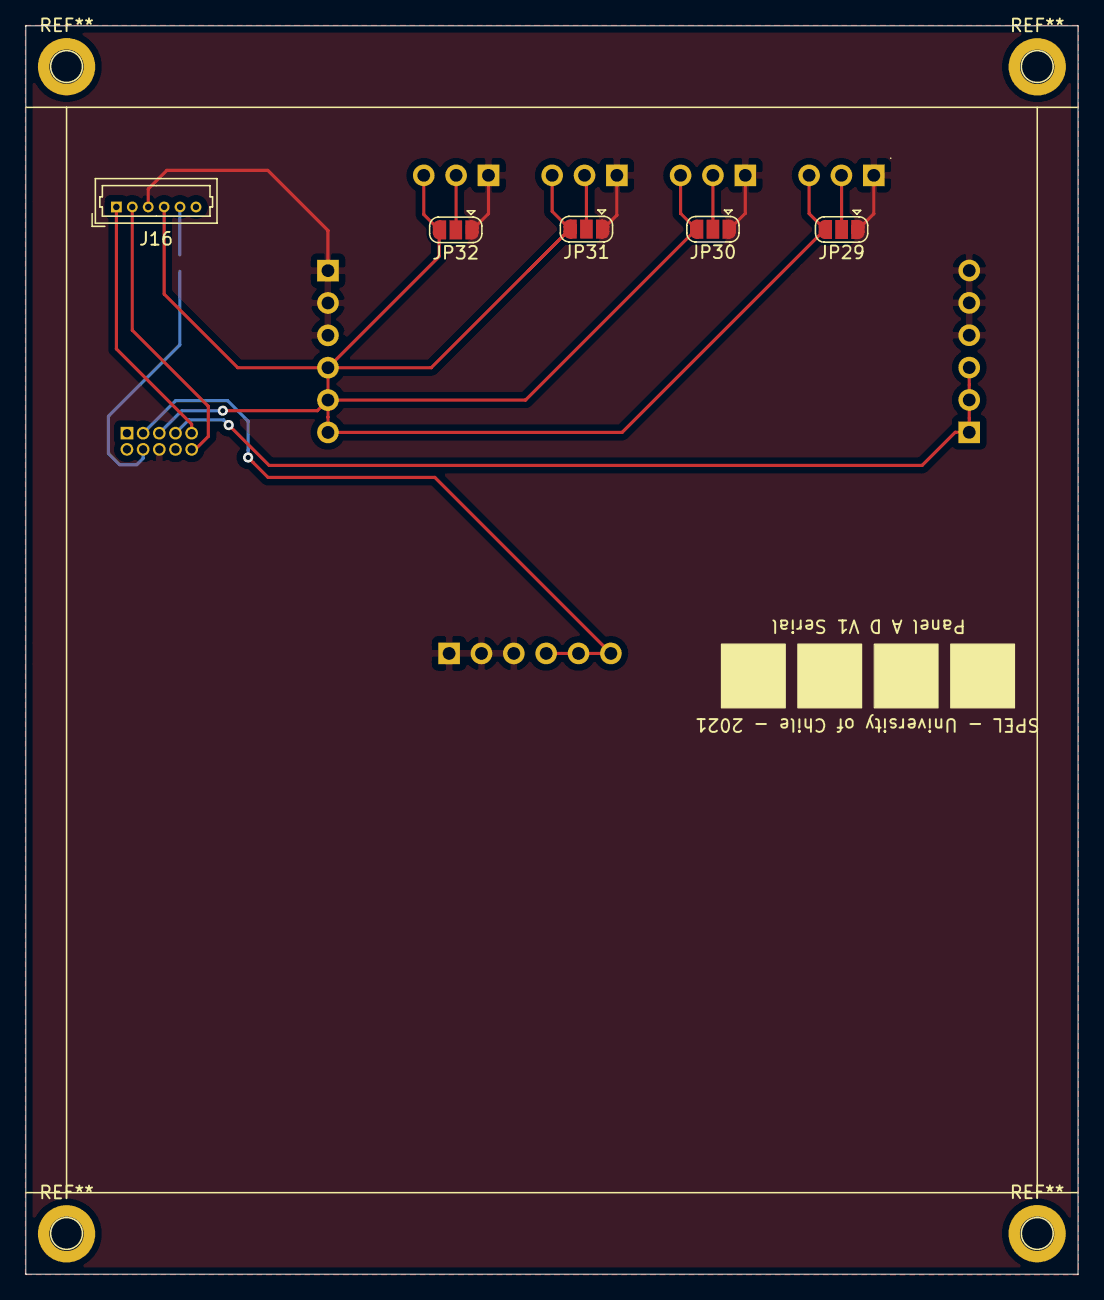
[picture p18: board PAD/MAG_Plus/MAG_Plus.kicad_pcb from above]

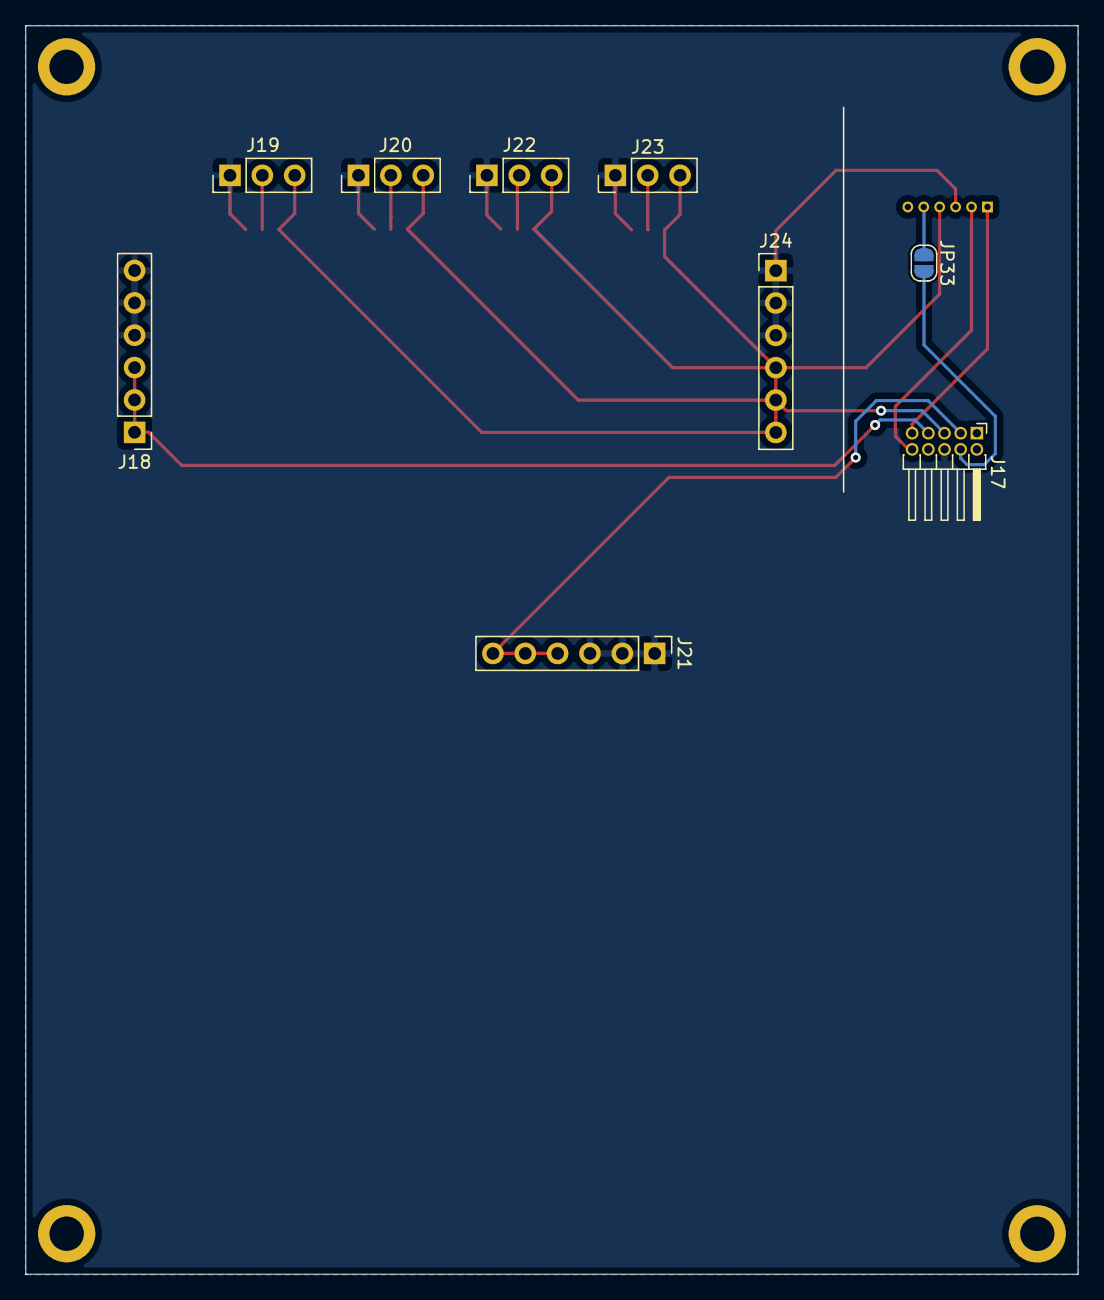
[picture p19: board PAD/MAG_Plus/MAG_Plus.kicad_pcb from below]

Board: 2 copper layers, 82.6 x 98.0 mm, 14 parts (9 on the bottom side), 12 nets.

Parts:
J16: Conn_01x06_Male; Molex_PicoBlade_53047-0610_06x1.25mm_Straight
J17: Conn_02x05_Counter_Clockwise; Pin_Header_Angled_2x05_Pitch1.27mm
J18, J21, J24: Conn_01x06_Male; Pin_Header_Straight_1x06_Pitch2.54mm
J19, J20, J22, J23: Conn_01x03_Male; Pin_Header_Straight_1x03_Pitch2.54mm
JP29, JP30, JP31, JP32: Jumper_3_Open; SolderJumper-3_P1.3mm_Open_RoundedPad1.0x1.5mm
JP33: Jumper_2_Open; SolderJumper-2_P1.3mm_Open_RoundedPad1.0x1.5mm

Connections:
ENN: J20.2, JP30.2
ENP: J23.2, JP32.2
GND: J16.3, J17.6, J18.4, J18.5, J18.6, J19.1, J20.1, J21.1, J21.2, J21.3, J22.1, J23.1, J24.1, J24.2, J24.3, JP29.1, JP30.1, JP31.1, JP32.1
LPS_3V3: J16.5, JP33.1
LPS_3V3J: J17.4, JP33.2
LPS_5V: J16.4, J17.5, J19.3, J20.3, J22.3, J23.3, J24.4, J24.5, J24.6, JP29.3, JP30.3, JP31.3, JP32.3
LPS_RX: J16.1, J17.9
LPS_TX: J16.2, J17.10
PSN: J19.2, JP29.2
PSP: J22.2, JP31.2
VNEG: J17.7, J18.1, J18.2, J18.3
VPOS: J17.3, J21.4, J21.5, J21.6
