spel-uchile/S2_S3_PS_MAG_PCBs/Panel B E S2/MAG_Plus/MAG_Plus.kicad_pcb

## KiCad design Panel B E S2/MAG_Plus/MAG_Plus.kicad_pcb (2022-08-22)

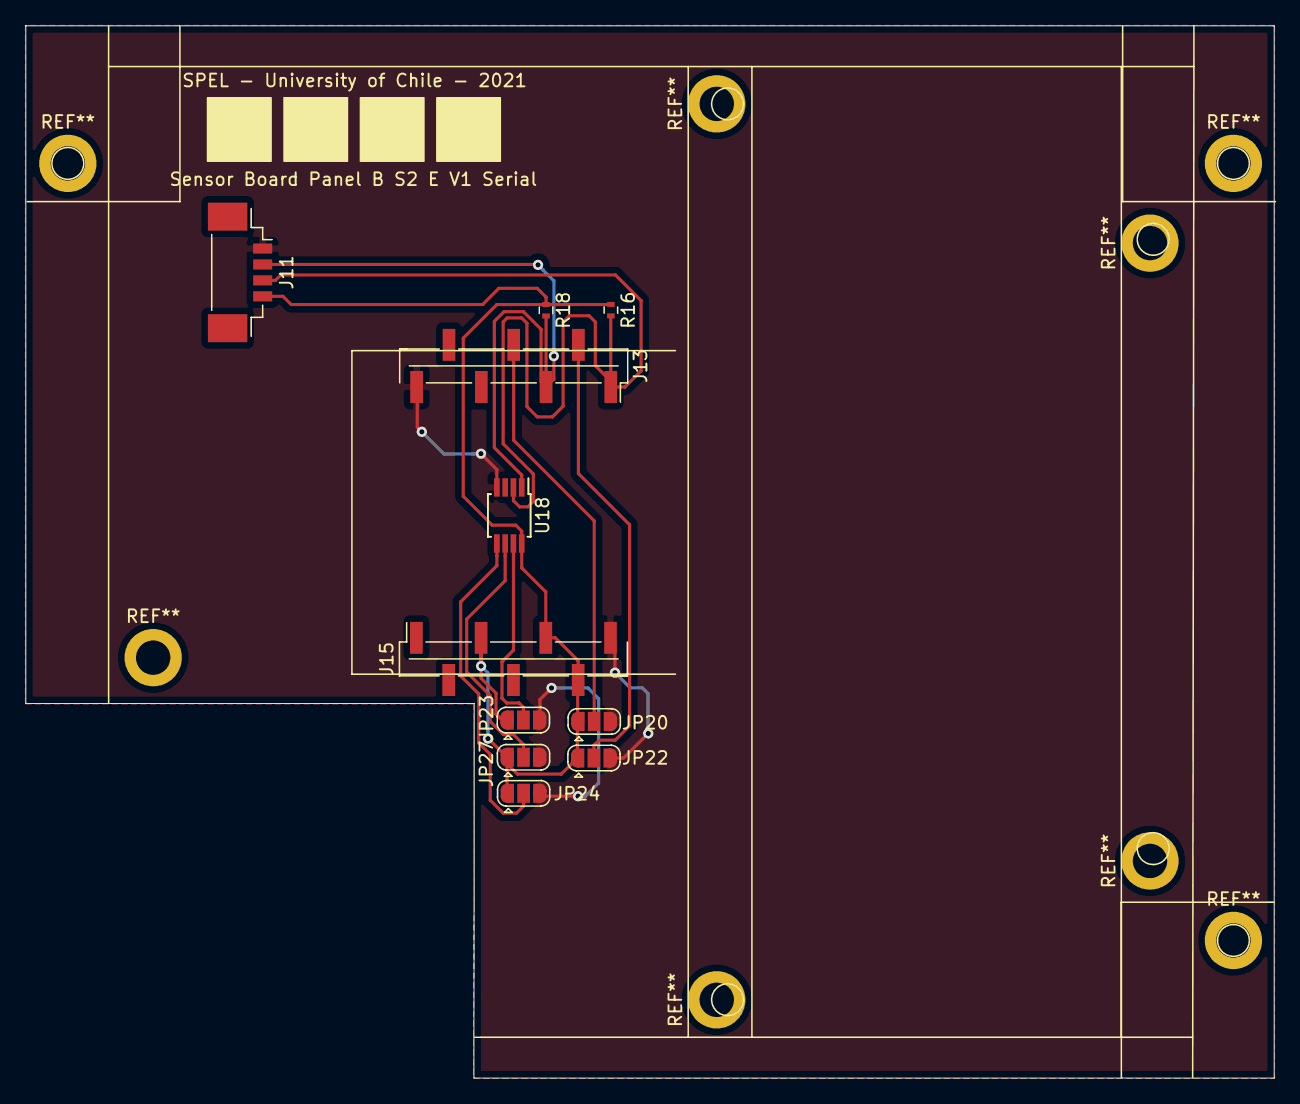
[picture p20: board Panel B E S2/MAG_Plus/MAG_Plus.kicad_pcb from above]

Board: 2 copper layers, 98.0 x 82.6 mm, 11 parts (0 on the bottom side), 9 nets.

Parts:
J11: Conn_01x04_Male; Molex_PicoBlade_53398-0471_04x1.25mm_Straight
J13, J15: Conn_01x07_Female; Pin_Header_Straight_1x07_Pitch2.54mm_SMD_Pin1Right
JP20, JP22, JP23, JP24, JP27: Jumper_3_Open; SolderJumper-3_P1.3mm_Open_RoundedPad1.0x1.5mm
R16, R18: R; R_0402
U18: MCP9804_MSOP; MSOP-8_3x3mm_Pitch0.65mm

Connections:
GND: J11.1, J13.7, J15.7, JP20.3, JP22.3, JP23.3, JP24.3, JP27.3, U18.4
MAG2_A0: JP23.2, U18.7
MAG2_A1: JP27.2, U18.6
MAG2_A2: JP24.2, U18.5
MAG2_BIT0: J13.4, JP20.2
MAG2_BIT1: J13.2, JP22.2
MAG_3V3: J11.4, J15.3, J15.5, J15.6, JP20.1, JP22.1, JP23.1, JP24.1, JP27.1, R16.1, R18.1, U18.8
RPI_SCL: J11.3, J13.1, R16.2, U18.2
RPI_SDA: J11.2, J13.3, R18.2, U18.1
