spel-uchile/S2_S3_PS_MAG_PCBs/PC104 - plansat/MAG_plus/Magnetometer_A.kicad_pcb

## KiCad design PC104 - plansat/MAG_plus/Magnetometer_A.kicad_pcb (2022-08-22)

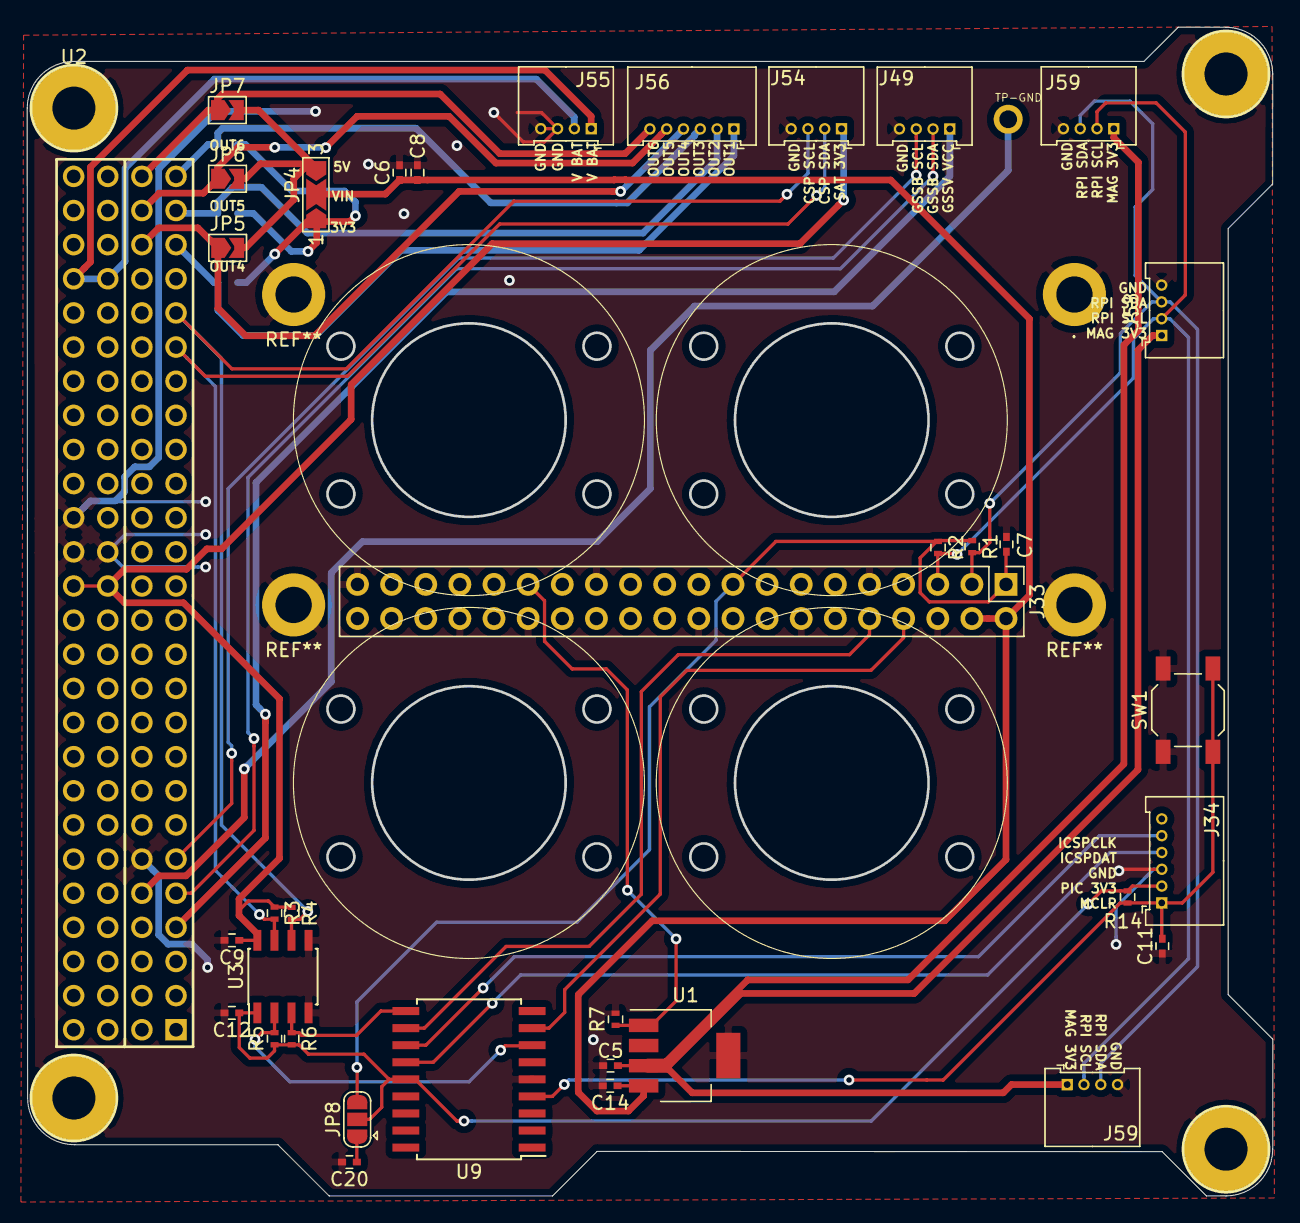
[picture p21: board Magnetometer_A.kicad_pcb from above]

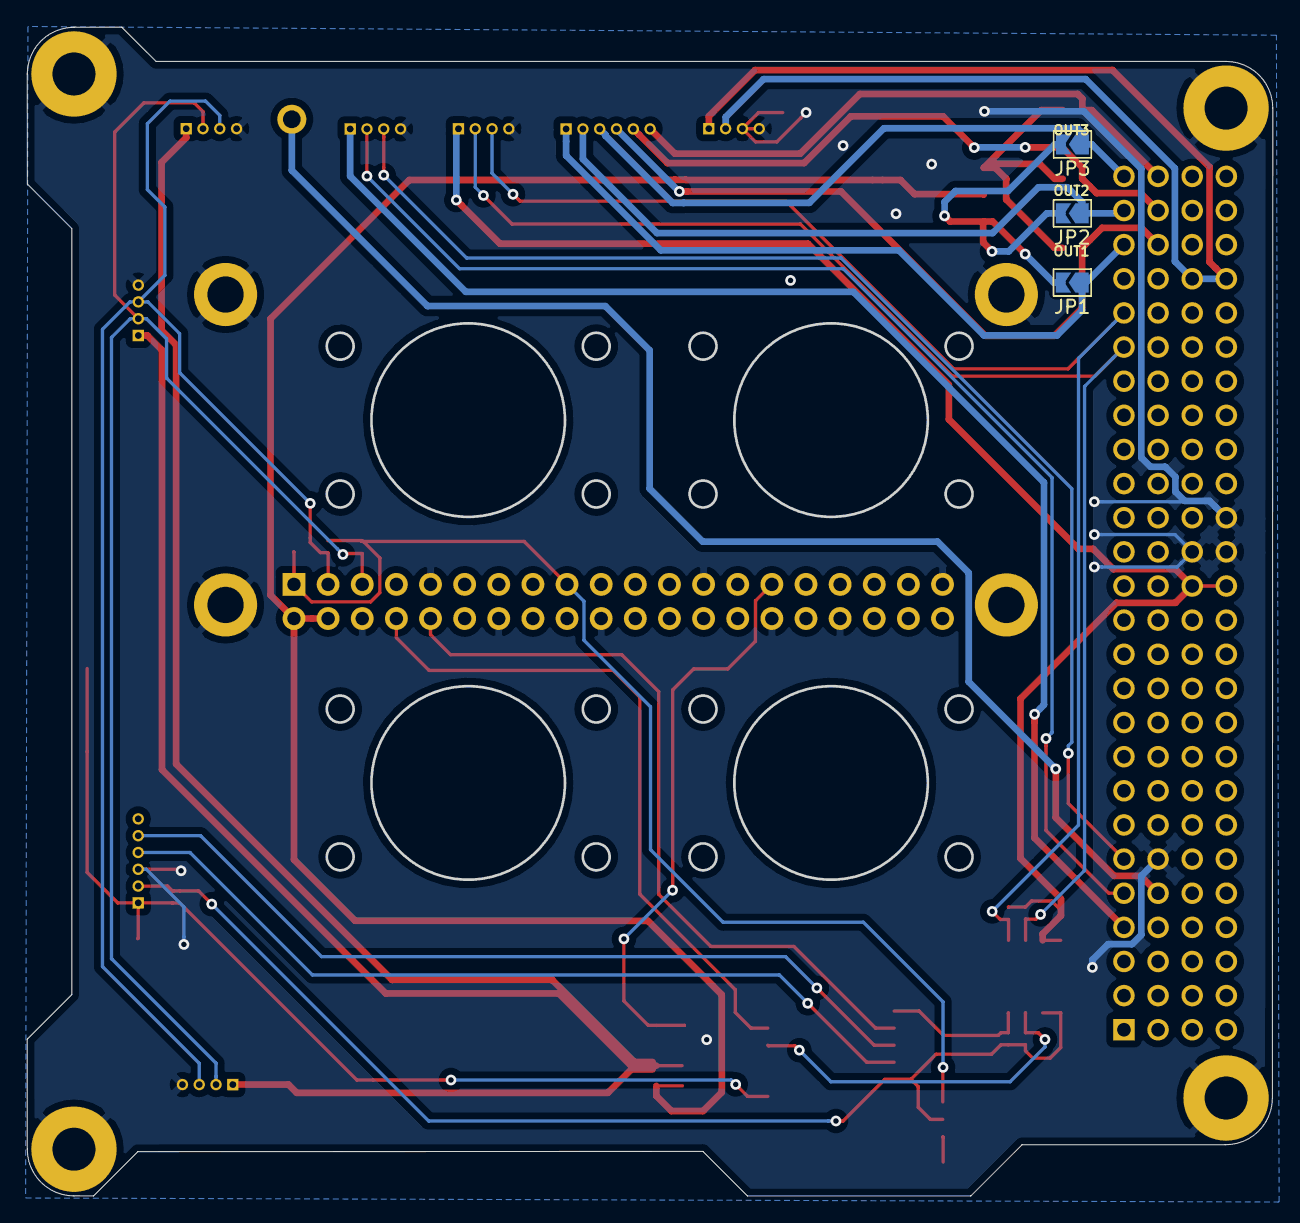
[picture p22: board Magnetometer_A.kicad_pcb from below]

Board: 2 copper layers, 92.7 x 87.0 mm, 41 parts (3 on the bottom side), 32 nets.

Parts:
.: MountingHole_2.7mm_M2.5_DIN965_Pad
C5, C6, C7, C8, C9, C11, C12, C14, C20: C; C_0402
J33: RPi_GPIO; Pin_Header_Straight_2x20_Pitch2.54mm
J34: Conn_01x06_Male; Molex_PicoBlade_53048-0610_06x1.25mm_Angled
J49, J54, J55: Conn_01x04_Female; Molex_PicoBlade_53048-0410_04x1.25mm_Angled
J56: Conn_01x06_Female; Molex_PicoBlade_53048-0610_06x1.25mm_Angled
J58, J59, J59#2: Conn_01x04_Male; Molex_PicoBlade_53048-0410_04x1.25mm_Angled
JP1, JP2, JP3, JP5, JP6, JP7: Jumper_2_Open; SolderJumper-2_P1.3mm_Open_TrianglePad1.0x1.5mm
JP4: Jumper_3_Open; SolderJumper-3_P2.0mm_Open_TrianglePad1.0x1.5mm_NumberLabels
JP8: Jumper_3_Open; SolderJumper-3_P1.3mm_Open_RoundedPad1.0x1.5mm
R1, R2, R3, R4, R5, R6, R7, R14: R; R_0402
SW1: SW_Push; SW_SPST_SKQG
TP-GND: PTR1PAD1-13; P1-13
U1: LP38693MP-3.3; SOT-223-5
U2: Payload; PC104-Standard
U3: ISO1540; SOIC-8_3.9x4.9mm_Pitch1.27mm
U9: PIC16F1847-I_SO; SOIC-18W_7.5x11.6mm_Pitch1.27mm

Connections:
3V3IN: JP1.2, JP2.2, JP3.2, JP4.1
5VIN: JP4.3, JP5.2, JP6.2, JP7.2
CSP_SCL: J54.3, R4.2, U2.43, U3.6
CSP_SDA: J54.2, R3.2, U2.41, U3.7
GND: ..1, C5.2, C6.2, C7.2, C8.2, C9.2, C11.1, C12.2, C14.2, C20.2, J33.6, J33.9, J33.14, J33.20, J33.25, J33.30, J33.34, J33.39, J34.3, J49.4, J54.4, J55.3, J55.4, J58.4, J59.4, J59#2.4, R7.2, SW1.1, U1.5, U2.12, U2.81, U2.82, U2.84, U3.4, U3.5, U9.5
GSSB_SCL: J49.3, U2.11
GSSB_SDA: J49.2, U2.9
GSSB_VCC: J49.1, U2.7
ICSPCLK: J34.5, U9.12
ICSPDAT: J34.4, U9.13
MAG_3V3: C5.1, J58.1, J59.1, J59#2.1, U1.3
MAG_EN: J33.29, R7.1, U1.1
MCLR: C11.2, J34.1, R14.2, SW1.2, U9.4
unnamed: TP-GND.TP, U2.10
OUT1_3V3: J56.1, JP1.1, U2.47
OUT2_3V3: J56.2, JP2.1, U2.49
OUT3_3V3: J56.3, JP3.1, U2.51
OUT4_5V0: J56.4, JP5.1, U2.48
OUT5_5V0: J56.5, JP6.1, U2.50
OUT6_5V0: J56.6, JP7.1, U2.52
PIC_3V3: C20.1, JP8.1
PIC_3V3J: C12.1, J34.2, JP8.2, R5.1, R6.1, R14.1, U3.1, U9.14
PIC_SCL: R6.2, U3.3, U9.10
PIC_SDA: R5.2, U3.2, U9.7
RPI_3V3: C7.1, J33.1, J33.17, JP8.3, R1.1, R2.1
RPI_RX: J33.10, U9.11
RPI_SCL: J33.5, J58.2, J59.2, J59#2.2, R2.2
RPI_SDA: J33.3, J58.3, J59.3, J59#2.3, R1.2
RPI_TX: J33.8, U9.8
SAT_3V3: C9.1, J54.1, R3.1, R4.1, U2.79, U2.80, U3.8
VIN: C6.1, C8.1, C14.1, J33.2, J33.4, JP4.2, U1.4
V_BAT: J55.1, J55.2, U2.97, U2.98
