spel-uchile/S2_S3_PS_MAG_PCBs/PC/PC_V1.2.kicad_pcb

## KiCad design PC/PC_V1.2.kicad_pcb (2022-08-22)

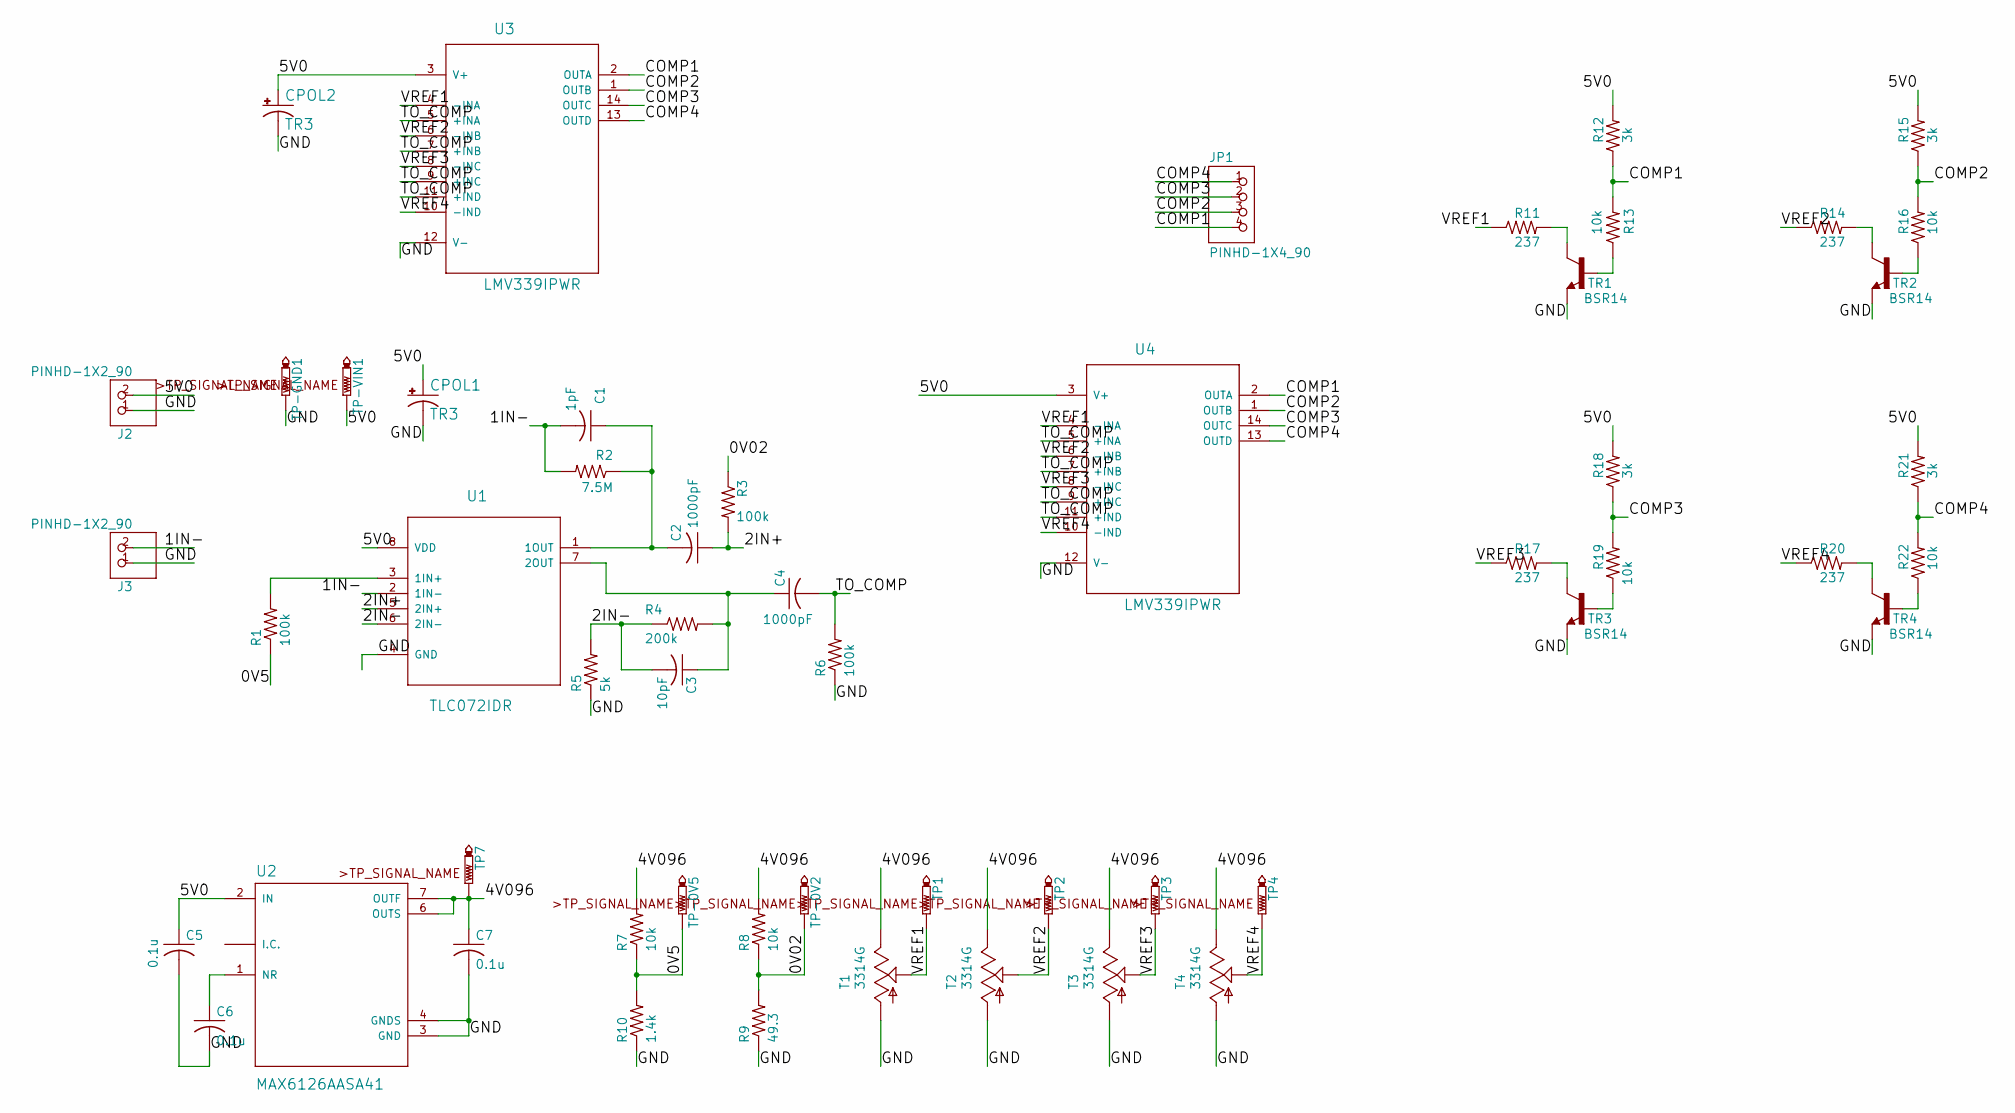
[picture p23: schematic PC_V1.2.sch]

Parts:
C1: 1pF; C0402
C2, C4: 1000pF; C0603
C3: 10pF; C0603
C5, C6, C7: 0.1u; C0402
CPOL1, CPOL2: TR3; EIA3528
J2, J3: PINHD-1X2_90; 1X02_90
JP1: PINHD-1X4_90; 1X04_90
R1, R3, R6: 100k; R0603
R2: 7.5M; R1206
R4: 200k; R0603
R5: 5k; R0402
R7, R8, R13, R16, R19, R22: 10k; R0603
R9: 49.3; R0603
R10: 1.4k; R0402
R11, R14, R17, R20: 237; R0603
R12, R15, R18, R21: 3k; R0603
T1, T2, T3, T4: 3314G
TP1, TP2, TP3, TP4, TP7: PTR1PAD1-13; P1-13
TP-0V2, TP-0V5: PTR1PAD1-13; P1-13
TP-GND1: PTR1PAD1-13; P1-13
TP-VIN1: PTR1PAD1-13; P1-13
TR1, TR2, TR3, TR4: BSR14; SOT95P240X120-3N
U1: TLC072IDR; SOIC127P600X175-8N
U2: MAX6126AASA41; SOIC127P600X175-8N
U3: LMV339IPWR; SOP65P640X110-14N
U4: LMV339IPWR; DIP-14_W7.62mm

Connections:
/0V02: R3.1, R8.1, R9.2, TP-0V2.TP
/0V5: R1.1, R7.1, R10.2, TP-0V5.TP
/1IN-: C1.2, J3.2, R2.2, U1.2 (1IN-)
/2IN+: C2.1, R3.2, U1.5 (2IN+)
/2IN-: C3.2, R4.1, R5.2, U1.6 (2IN-)
/4V096: C7.1, R7.2, R8.2, T1.3, T2.3, T3.3, T4.3, TP7.TP, U2.6 (OUTS), U2.7 (OUTF)
/5V0: C5.1, CPOL1.A (+), CPOL2.A (+), J2.2, R12.2, R15.2, R18.2, R21.2, TP-VIN1.TP, U1.8 (VDD), U2.2 (IN), U3.3 (V+), U4.3 (V+)
/COMP1: JP1.4, R12.1, R13.2, U3.2 (OUTA), U4.2 (OUTA)
/COMP2: JP1.3, R15.1, R16.2, U3.1 (OUTB), U4.1 (OUTB)
/COMP3: JP1.2, R18.1, R19.2, U3.14 (OUTC), U4.14 (OUTC)
/COMP4: JP1.1, R21.1, R22.2, U3.13 (OUTD), U4.13 (OUTD)
/GND: C5.2, C6.2, C7.2, CPOL1.C (-), CPOL2.C (-), J2.1, J3.1, R5.1, R6.1, R9.1, R10.1, T1.1, T2.1, T3.1, T4.1, TP-GND1.TP, TR1.2 (E), TR2.2 (E), TR3.2 (E), TR4.2 (E), U1.4 (GND), U2.3 (GND), U2.4 (GNDS), U3.12 (V-), U4.12 (V-)
/TO_COMP: C4.2, R6.2, U3.5 (+INA), U3.7 (+INB), U3.9 (+INC), U3.11 (+IND), U4.5 (+INA), U4.7 (+INB), U4.9 (+INC), U4.11 (+IND)
/VREF1: R11.1, T1.2, TP1.TP, U3.4 (-INA), U4.4 (-INA)
/VREF2: R14.1, T2.2, TP2.TP, U3.6 (-INB), U4.6 (-INB)
/VREF3: R17.1, T3.2, TP3.TP, U3.8 (-INC), U4.8 (-INC)
/VREF4: R20.1, T4.2, TP4.TP, U3.10 (-IND), U4.10 (-IND)
unnamed: C1.1, C2.2, R2.1, U1.1 (1OUT)
unnamed: C3.1, C4.1, R4.2, U1.7 (2OUT)
unnamed: C6.1, U2.1 (NR)
unnamed: R1.2, U1.3 (1IN+)
unnamed: R11.2, TR1.3 (C)
unnamed: R13.1, TR1.1 (B)
unnamed: R14.2, TR2.3 (C)
unnamed: R16.1, TR2.1 (B)
unnamed: R17.2, TR3.3 (C)
unnamed: R19.1, TR3.1 (B)
unnamed: R20.2, TR4.3 (C)
unnamed: R22.1, TR4.1 (B)
unnamed: U2.5 (I.C.), U2.8 (I.C.)

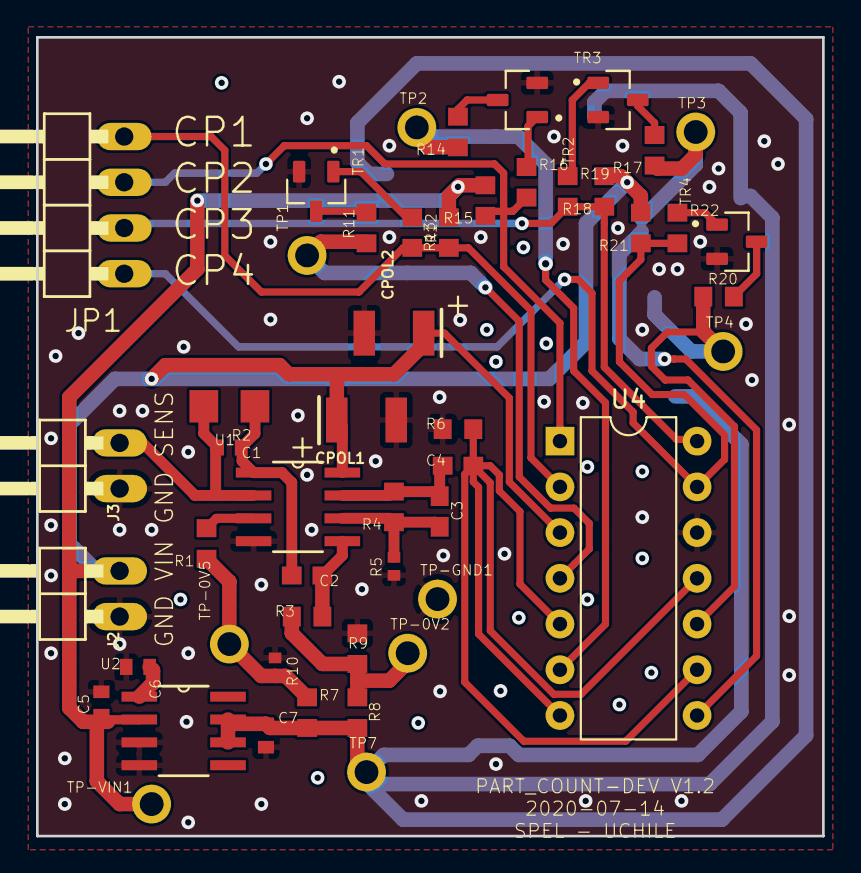
[picture p24: board PC_V1.2.kicad_pcb from above]

Board: 2 copper layers, 43.7 x 44.4 mm, 54 parts (0 on the bottom side), 30 nets.
