spel-uchile/S2_S3_PS_MAG_PCBs/Panel B I S3 PC/MAG_Plus/MAG_Plus.kicad_pcb

## KiCad design Panel B I S3 PC/MAG_Plus/MAG_Plus.kicad_pcb (2022-08-22)

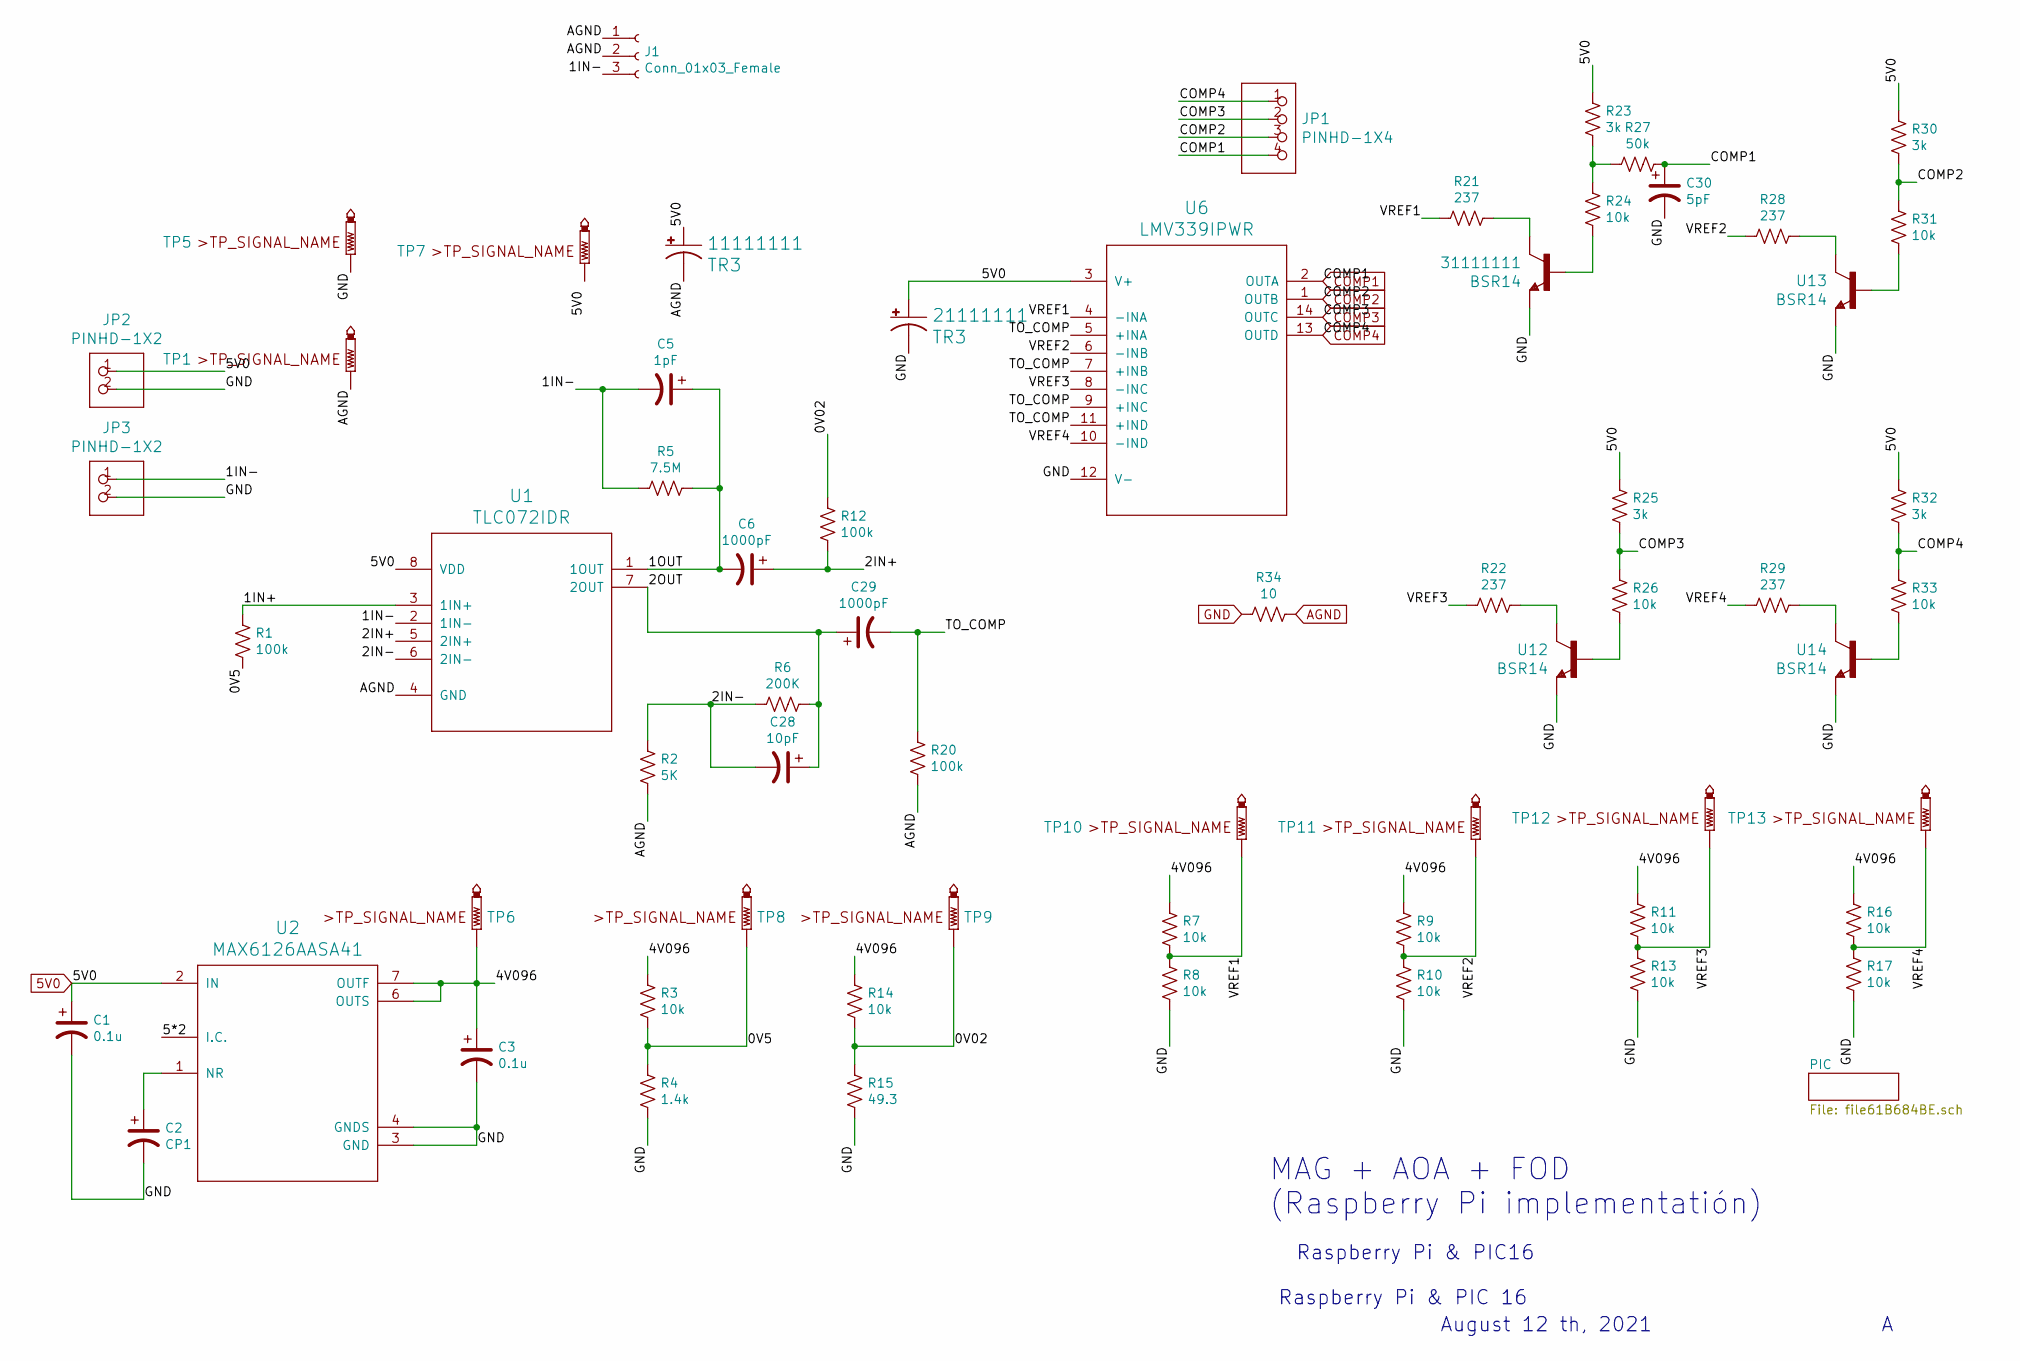
[picture p25: schematic MAG_Plus.sch]

Parts:
11111111, 21111111: TR3; EIA3528
31111111: BSR14; SOT95P240X120-3N
C1, C3: 0.1u; C0402
C2: CP1; C0402
C5: 1pF; C0402
C6, C29: 1000pF; C0603
C28: 10pF; C0603
C30: 5pF; C0603
J1: Conn_01x03_Female; TO-8-3_Window
JP1: PINHD-1X4; 1X04_90
JP2, JP3: PINHD-1X2; 1X02_90
R1, R12, R20: 100k; R0603
R2: 5K; R0402
R3, R7, R8, R9, R10, R11, R13, R14, R16, R17, R24, R26, R31, R33: 10k; R0603
R4: 1.4k; R0402
R5: 7.5M; R1206
R6: 200K; R0603
R15: 49.3; R0603
R21, R22, R28, R29: 237; R0603
R23, R25, R30, R32: 3k; R0603
R27: 50k; R0603
R34: 10; R0603
TP1, TP5, TP7: PTR1B1,27; P1-13
TP6, TP8, TP9, TP10, TP11, TP12, TP13: PTR1PAD1-13; P1-13
U1: TLC072IDR; SOIC127P600X175-8N
U2: MAX6126AASA41; SOIC127P600X175-8N
U6: LMV339IPWR; SOP65P640X110-14N
U12, U13, U14: BSR14; SOT95P240X120-3N

Connections:
5V0: 11111111.A (+), 21111111.A (+), C1.1, JP2.1, R23.1, R25.1, R30.1, R32.1, U1.8 (VDD), U2.2 (IN), U6.3 (V+); also elsewhere on the board
/0V02: R12.1, R14.2, R15.1, TP9.TP
/0V5: R1.2, R3.2, R4.1, TP8.TP
/1IN+: R1.1, U1.3 (1IN+)
/1IN-: C5.2, J1.3, JP3.1, R5.1, U1.2 (1IN-)
/1OUT: C5.1, C6.2, R5.2, U1.1 (1OUT)
/2IN+: C6.1, R12.2, U1.5 (2IN+)
/2IN-: C28.2, R2.1, R6.1, U1.6 (2IN-)
/2OUT: C28.1, C29.1, R6.2, U1.7 (2OUT)
/4V096: C3.1, R3.1, R7.1, R9.1, R11.1, R14.1, R16.1, TP6.TP, U2.6 (OUTS), U2.7 (OUTF)
/5*2: U2.5 (I.C.), U2.8 (I.C.)
/TO_COMP: C29.2, R20.1, U6.5 (+INA), U6.7 (+INB), U6.9 (+INC), U6.11 (+IND)
/VREF1: R7.2, R8.1, R21.1, TP10.TP, U6.4 (-INA)
/VREF2: R9.2, R10.1, R28.1, TP11.TP, U6.6 (-INB)
/VREF3: R11.2, R13.1, R22.1, TP12.TP, U6.8 (-INC)
/VREF4: R16.2, R17.1, R29.1, TP13.TP, U6.10 (-IND)
AGND: 11111111.C (-), J1.1, J1.2, R2.2, R20.2, R34.2, TP1.TP, U1.4 (GND)
COMP1: C30.1, JP1.4, R27.1, U6.2 (OUTA); also elsewhere on the board
COMP2: JP1.3, R30.2, R31.1, U6.1 (OUTB); also elsewhere on the board
COMP3: JP1.2, R25.2, R26.1, U6.14 (OUTC); also elsewhere on the board
COMP4: JP1.1, R32.2, R33.1, U6.13 (OUTD); also elsewhere on the board
GND: 21111111.C (-), 31111111.2 (E), C1.2, C2.2, C3.2, C30.2, JP2.2, JP3.2, R4.2, R8.2, R10.2, R13.2, R15.2, R17.2, R34.1, TP5.TP, U2.3 (GND), U2.4 (GNDS), U6.12 (V-), U12.2 (E), U13.2 (E), U14.2 (E); also elsewhere on the board
unnamed: 31111111.1 (B), R24.2
unnamed: 31111111.3 (C), R21.2
unnamed: C2.1, U2.1 (NR)
unnamed: R22.2, U12.3 (C)
unnamed: R23.2, R24.1, R27.2
unnamed: R26.2, U12.1 (B)
unnamed: R28.2, U13.3 (C)
unnamed: R29.2, U14.3 (C)
unnamed: R31.2, U13.1 (B)
unnamed: R33.2, U14.1 (B)

Notes on the sheet:
August 12 th, 2021
Raspberry Pi & PIC 16
Raspberry Pi & PIC16
MAG + AOA + FOD (Raspberry Pi implementatión)

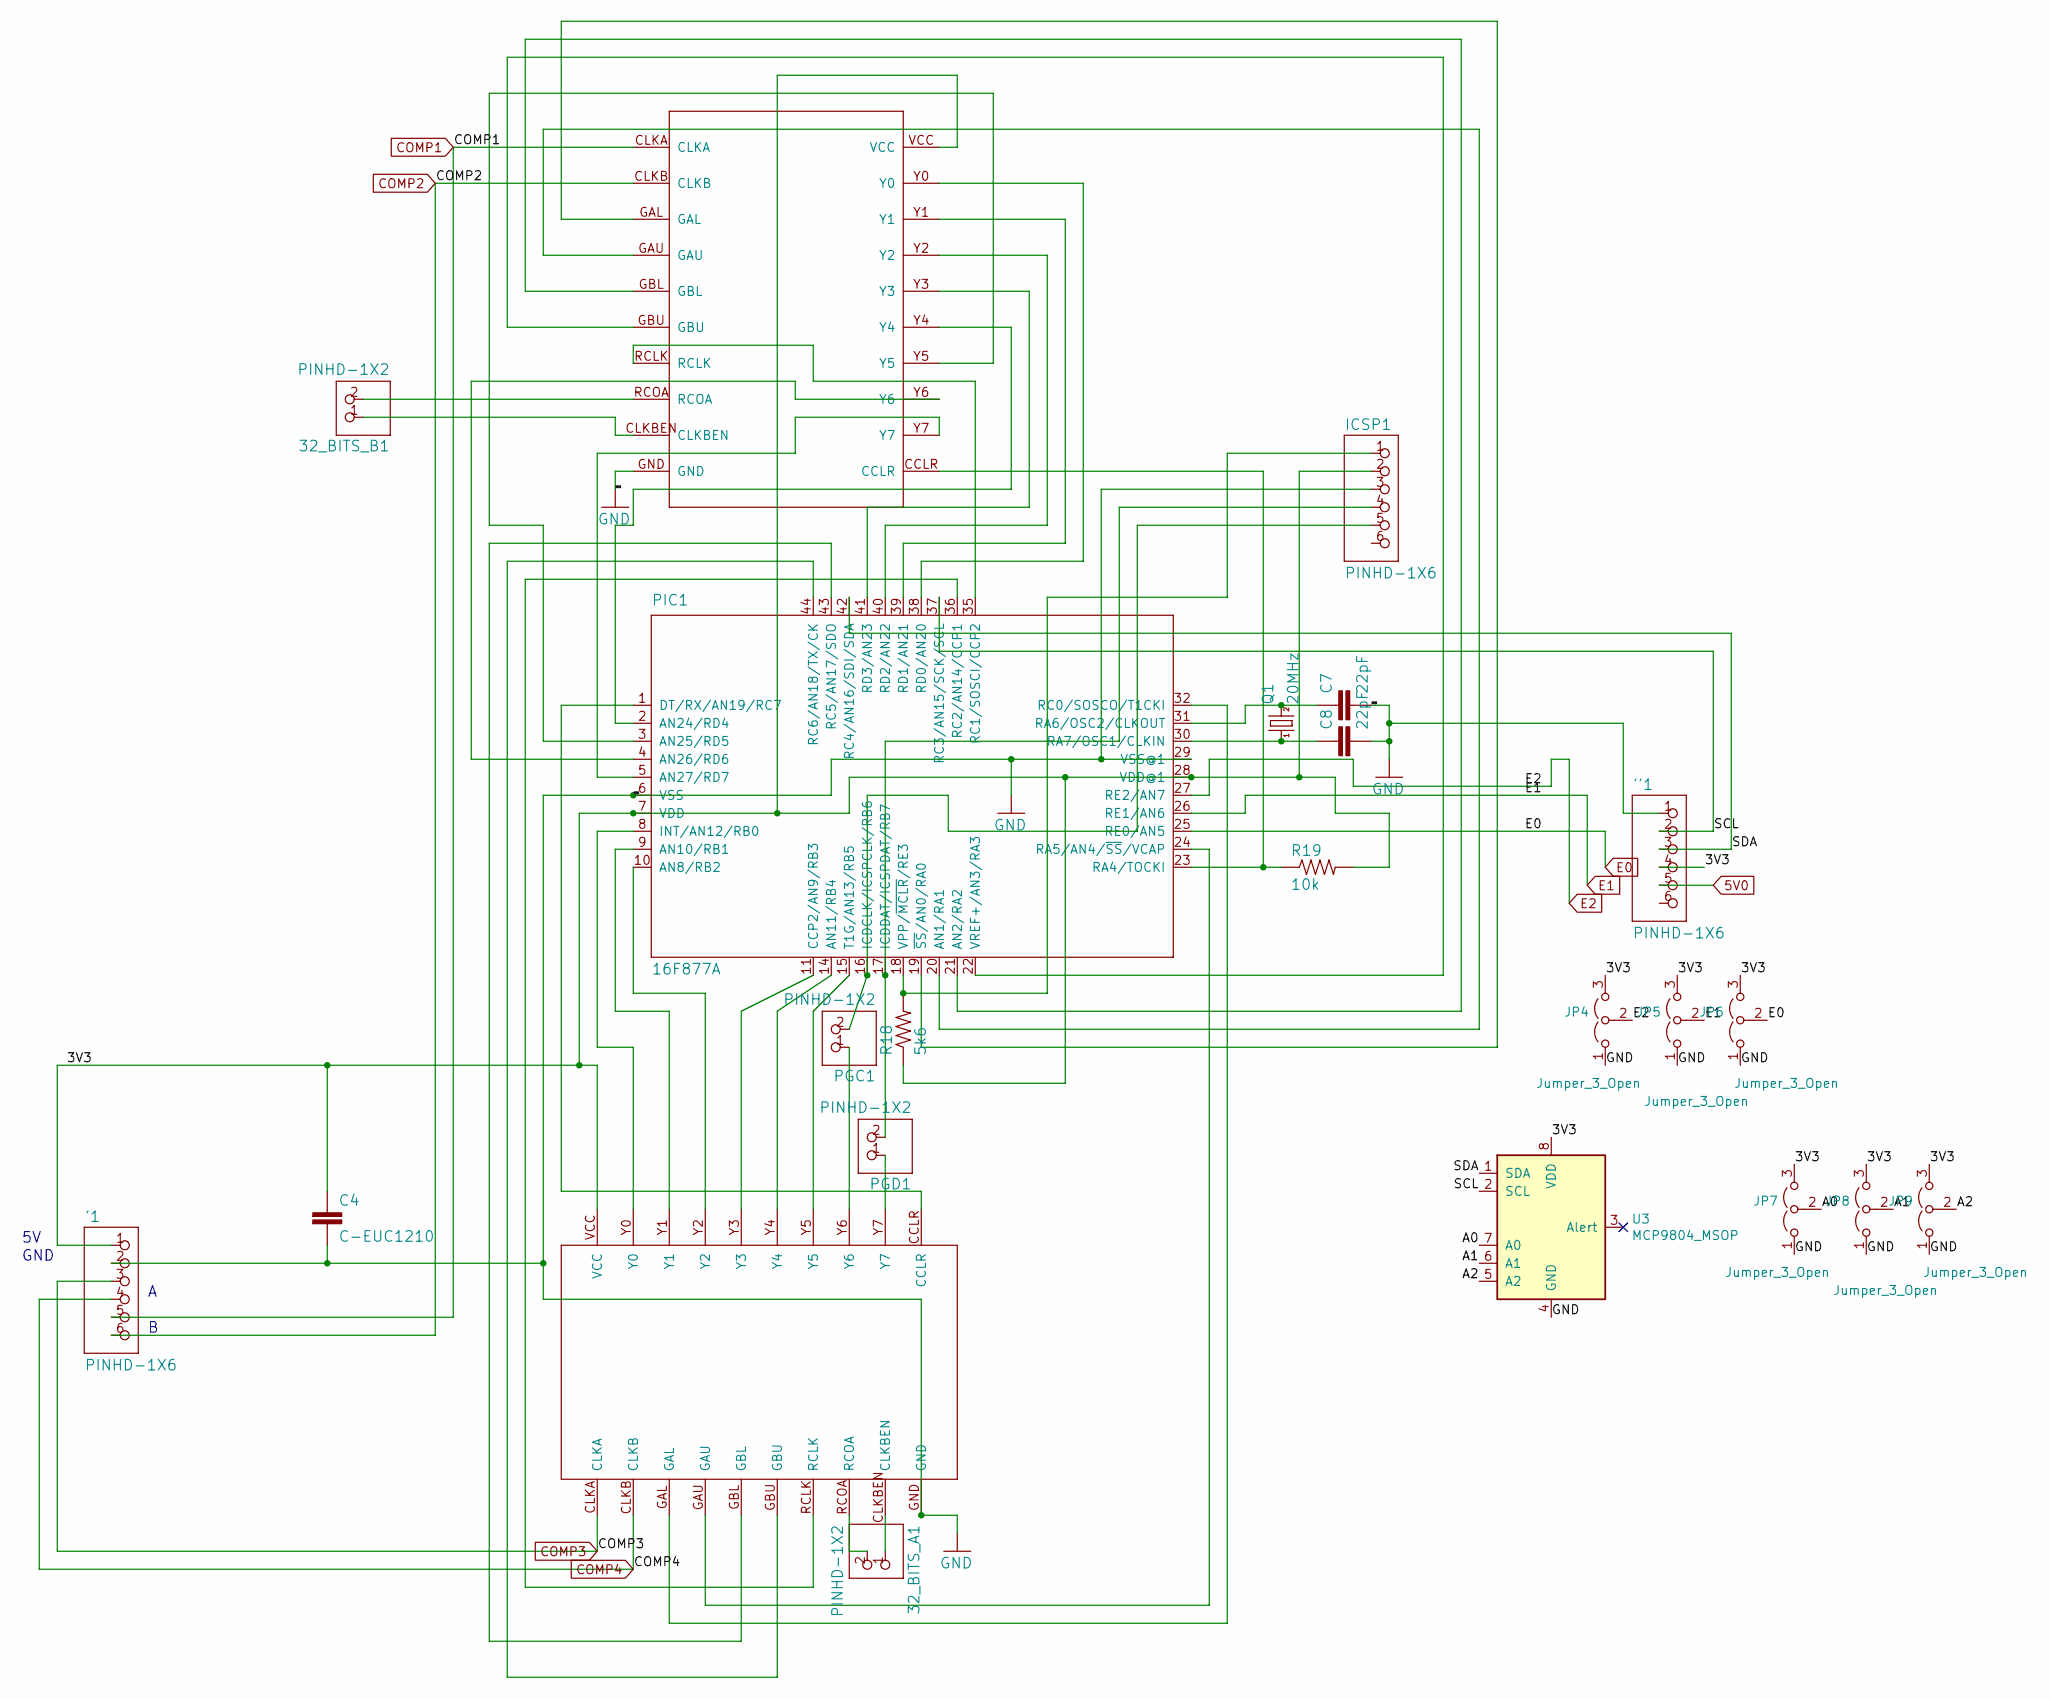
[picture p26: schematic file61B684BE.sch]

Parts:
32_BITS_A1, 32_BITS_B1: PINHD-1X2; SolderJumper-2_P1.3mm_Open_RoundedPad1.0x1.5mm
'1: PINHD-1X6; Molex_PicoBlade_53047-0610_06x1.25mm_Straight
''1: PINHD-1X6; Molex_PicoBlade_53047-0610_06x1.25mm_Straight
C4: C-EUC1210; C1210
C7, C8: 22pF; C0805
CONTA1: 74LV8154; PW20_TSSOP
CONTB1: 74LV8154; PW20_TSSOP
ICSP1: PINHD-1X6; Molex_PicoBlade_53047-0610_06x1.25mm_Straight
JP4, JP5, JP6, JP7, JP8, JP9: Jumper_3_Open; SolderJumper-3_P1.3mm_Open_RoundedPad1.0x1.5mm
PGC1: PINHD-1X2; SolderJumper-2_P1.3mm_Open_RoundedPad1.0x1.5mm
PGD1: PINHD-1X2; SolderJumper-2_P1.3mm_Open_RoundedPad1.0x1.5mm
PIC1: 16F877A; TQFP44
Q1: 20MHz; HC49_S
R18: 5k6; M1206
R19: 10k; M1206
U3: MCP9804_MSOP; MSOP-8_3x3mm_Pitch0.65mm

Connections:
5V0: ''1.5; also elsewhere on the board
/PIC/3V3: '1.1, ''1.4, C4.1, CONTA1.VCC, CONTB1.VCC, ICSP1.2, JP4.3 (B), JP5.3 (B), JP6.3 (B), JP7.3 (B), JP8.3 (B), JP9.3 (B), PIC1.7 (VDD), PIC1.28 (VDD@1), R18.1, R19.2, U3.8 (VDD)
/PIC/A0: JP7.2 (C), U3.7 (A0)
/PIC/A1: JP8.2 (C), U3.6 (A1)
/PIC/A2: JP9.2 (C), U3.5 (A2)
/PIC/SCL: ''1.2, PIC1.37 (RC3/AN15/SCK/SCL), U3.2 (SCL)
/PIC/SDA: ''1.3, PIC1.42 (RC4/AN16/SDI/SDA), U3.1 (SDA)
COMP1: '1.5, CONTB1.CLKA; also elsewhere on the board
COMP2: '1.6, CONTB1.CLKB; also elsewhere on the board
COMP3: '1.3, CONTA1.CLKA; also elsewhere on the board
COMP4: '1.4, CONTA1.CLKB; also elsewhere on the board
E0: JP6.2 (C), PIC1.25 (RE0/AN5)
E1: JP5.2 (C), PIC1.26 (RE1/AN6)
E2: JP4.2 (C), PIC1.27 (RE2/AN7)
GND: '1.2, ''1.1, C4.2, C7.2, C8.2, CONTA1.GND, CONTB1.GND, ICSP1.3, JP4.1 (A), JP5.1 (A), JP6.1 (A), JP7.1 (A), JP8.1 (A), JP9.1 (A), PIC1.6 (VSS), PIC1.29 (VSS@1), U3.4 (GND); also elsewhere on the board
unnamed: 32_BITS_A1.1, CONTA1.CLKBEN
unnamed: 32_BITS_A1.2, CONTA1.RCOA
unnamed: 32_BITS_B1.1, CONTB1.CLKBEN
unnamed: 32_BITS_B1.2, CONTB1.RCOA
unnamed: C7.1, PIC1.31 (RA6/OSC2/CLKOUT), Q1.2
unnamed: C8.1, PIC1.30 (RA7/OSC1/CLKIN), Q1.1
unnamed: CONTA1.CCLR, PIC1.1 (DT/RX/AN19/RC7)
unnamed: CONTA1.GAL, PIC1.32 (RC0/SOSCO/T1CKI)
unnamed: CONTA1.GAU, PIC1.24 (RA5/AN4/~SS~/VCAP)
unnamed: CONTA1.GBL, PIC1.43 (RC5/AN17/SDO)
unnamed: CONTA1.GBU, PIC1.44 (RC6/AN18/TX/CK)
unnamed: CONTA1.RCLK, PIC1.36 (RC2/AN14/CCP1)
unnamed: CONTA1.Y0, PIC1.8 (INT/AN12/RB0)
unnamed: CONTA1.Y1, PIC1.9 (AN10/RB1)
unnamed: CONTA1.Y2, PIC1.10 (AN8/RB2)
unnamed: CONTA1.Y3, PIC1.11 (CCP2/AN9/RB3)
unnamed: CONTA1.Y4, PIC1.14 (AN11/RB4)
unnamed: CONTA1.Y5, PIC1.15 (T1G/AN13/RB5)
unnamed: CONTA1.Y6, PGC1.1
unnamed: CONTA1.Y7, PGD1.1
unnamed: CONTB1.CCLR, PIC1.23 (RA4/TOCKI), R19.1
unnamed: CONTB1.GAL, PIC1.19 (~SS~/AN0/RA0)
unnamed: CONTB1.GAU, PIC1.20 (AN1/RA1)
unnamed: CONTB1.GBL, PIC1.21 (AN2/RA2)
unnamed: CONTB1.GBU, PIC1.22 (VREF+/AN3/RA3)
unnamed: CONTB1.RCLK, PIC1.35 (RC1/SOSCI/CCP2)
unnamed: CONTB1.Y0, PIC1.38 (RD0/AN20)
unnamed: CONTB1.Y1, PIC1.39 (RD1/AN21)
unnamed: CONTB1.Y2, PIC1.40 (RD2/AN22)
unnamed: CONTB1.Y3, PIC1.41 (RD3/AN23)
unnamed: CONTB1.Y4, PIC1.2 (AN24/RD4)
unnamed: CONTB1.Y5, PIC1.3 (AN25/RD5)
unnamed: CONTB1.Y6, PIC1.4 (AN26/RD6)
unnamed: CONTB1.Y7, PIC1.5 (AN27/RD7)
unnamed: ICSP1.1, PIC1.18 (VPP/~MCLR~/RE3), R18.2
unnamed: ICSP1.4, PGD1.2, PIC1.17 (ICDDAT/ICSPDAT/RB7)
unnamed: ICSP1.5, PGC1.2, PIC1.16 (ICDCLK/ICSPCLK/RB6)

Notes on the sheet:
GND

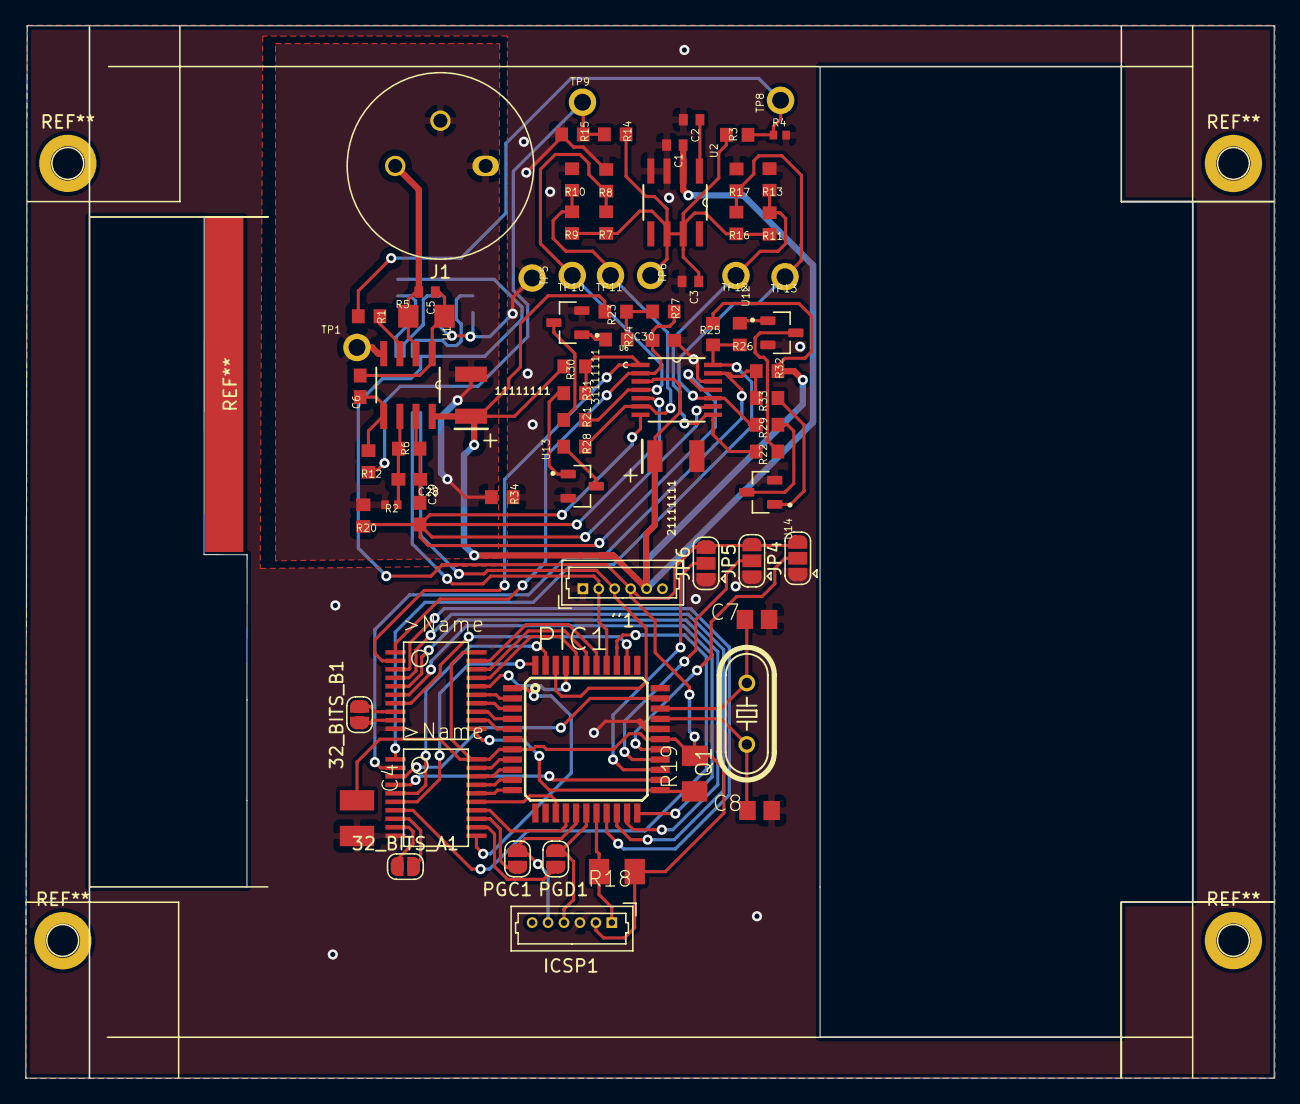
[picture p27: board Panel B I S3 PC/MAG_Plus/MAG_Plus.kicad_pcb from above]

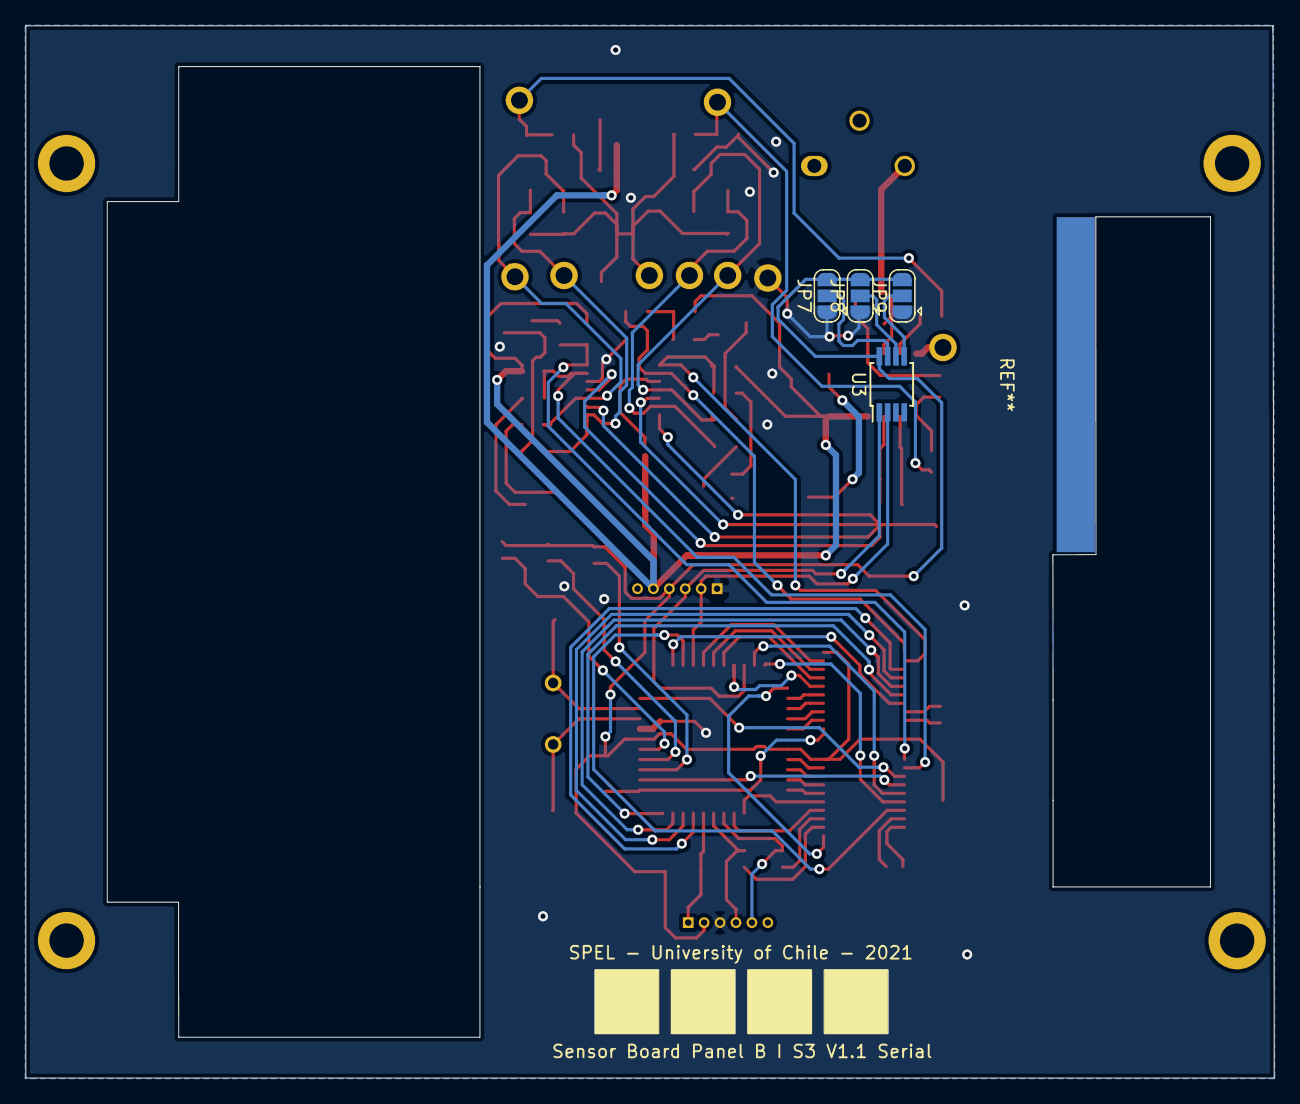
[picture p28: board Panel B I S3 PC/MAG_Plus/MAG_Plus.kicad_pcb from below]

Board: 2 copper layers, 98.0 x 82.6 mm, 81 parts (4 on the bottom side), 78 nets.
