spel-uchile/S2_S3_PS_MAG_PCBs/Grafeno V2/TG_SAT_24V0_V1.4.brd

## EAGLE design Grafeno V2/TG_SAT_24V0_V1.4.brd (2022-08-22)

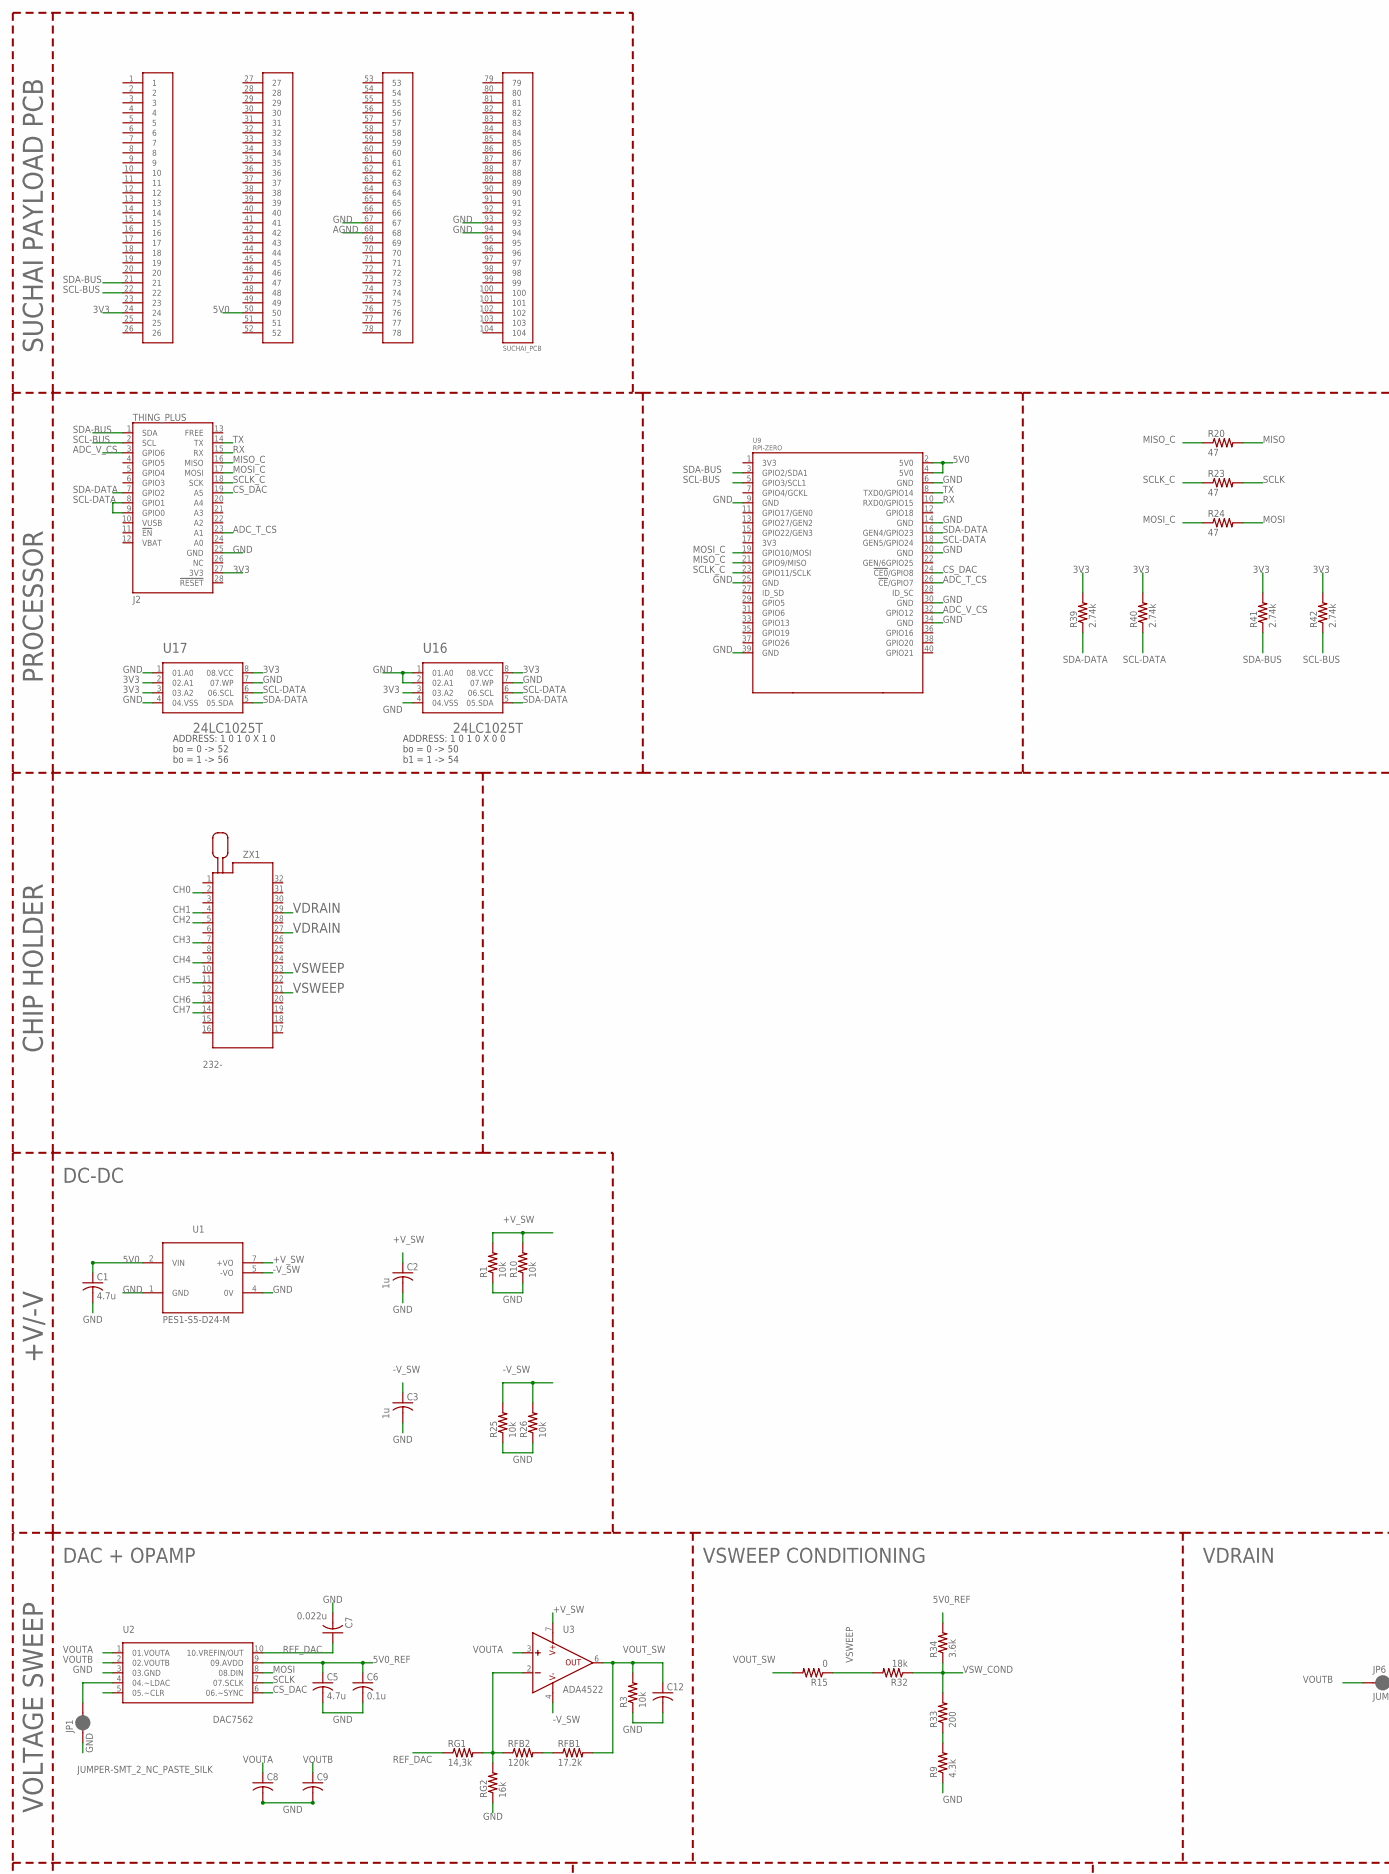
[picture p29: schematic TG_SAT_24V0_V1.4.sch, part in row 1, column 1]

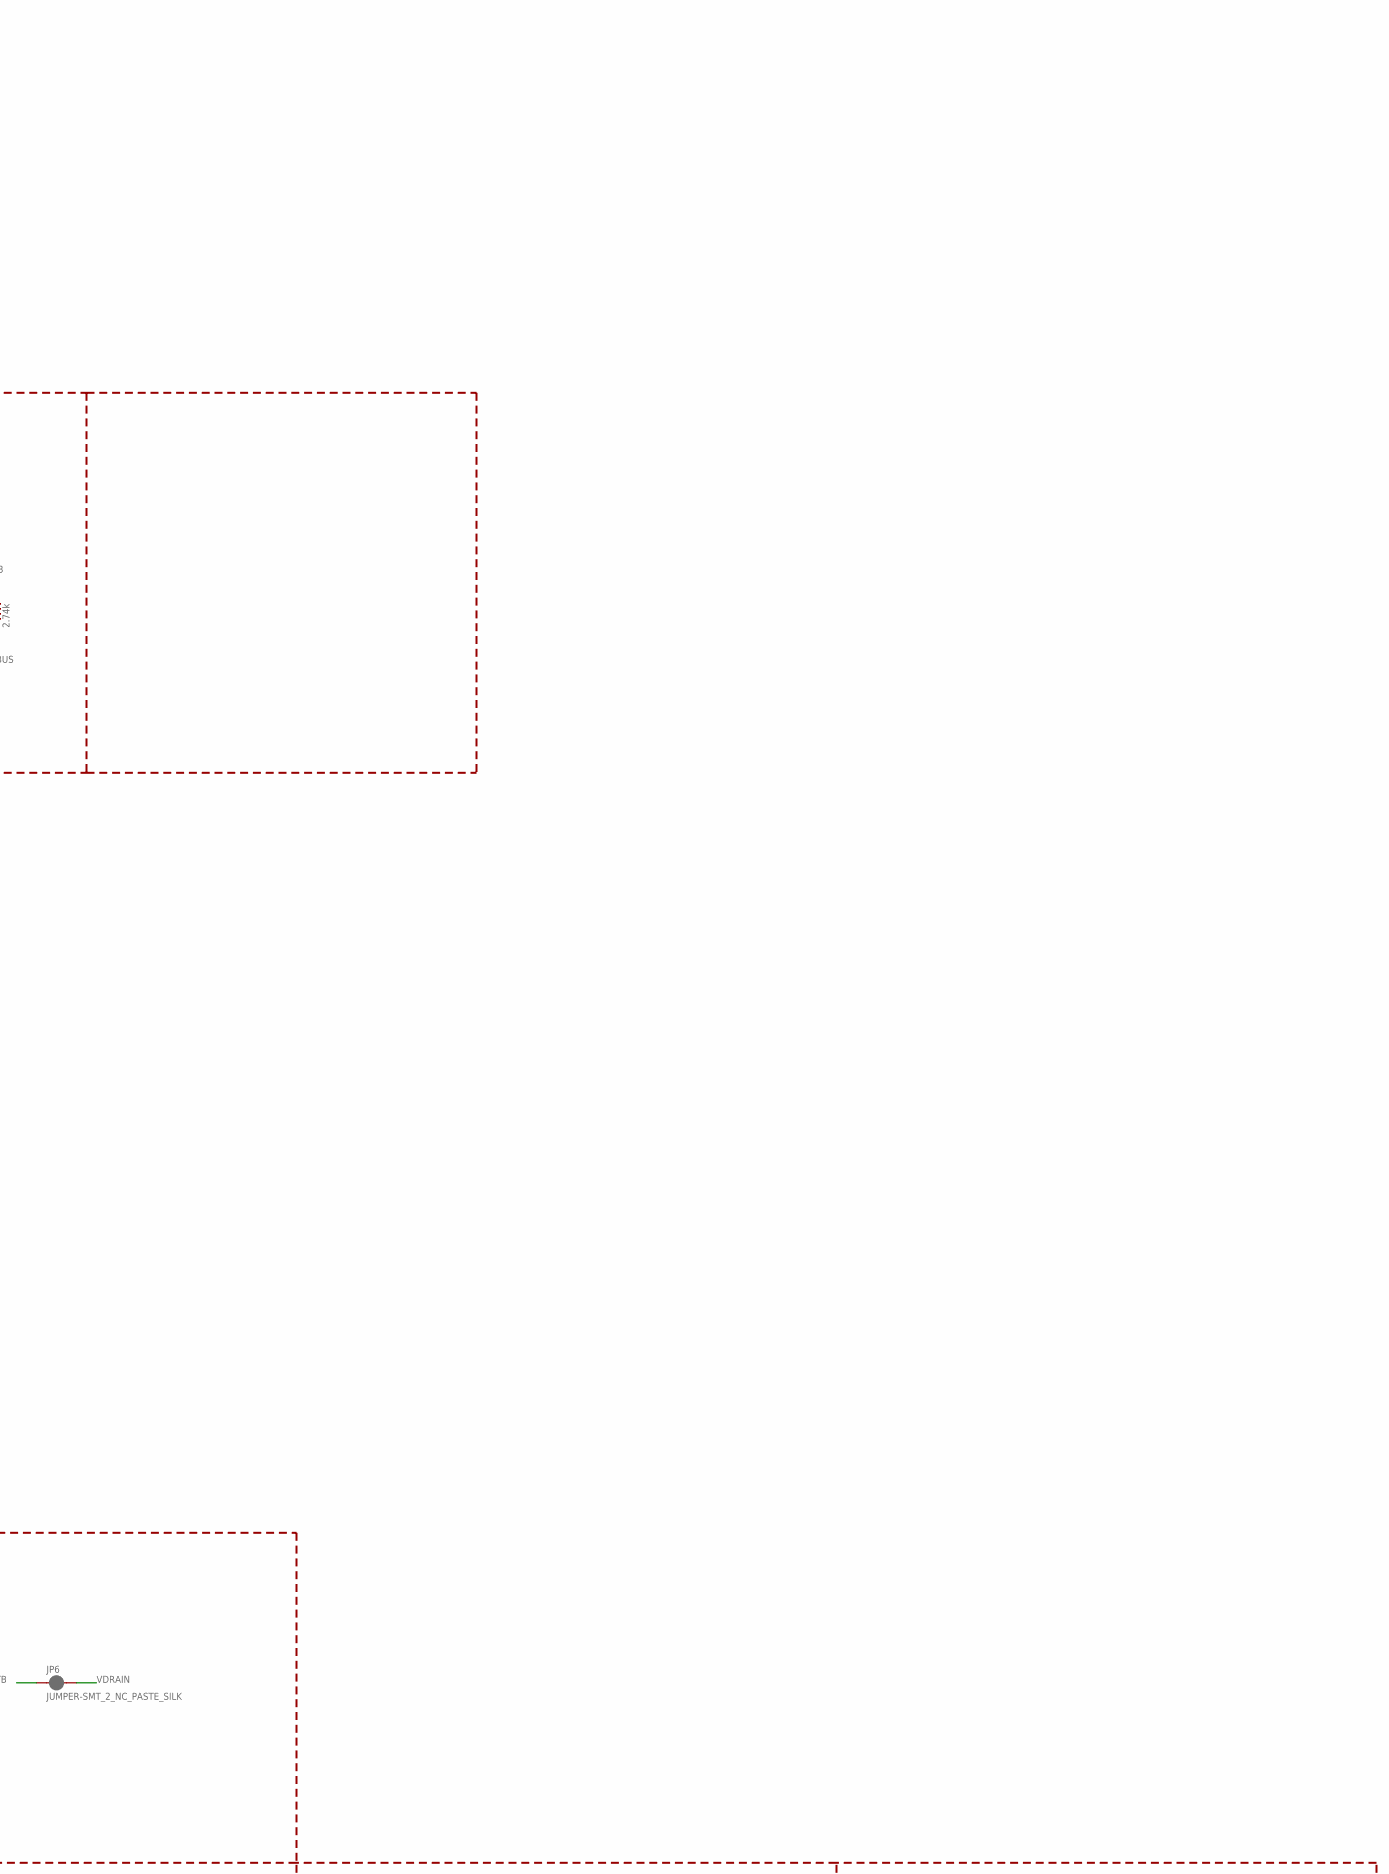
[picture p30: schematic TG_SAT_24V0_V1.4.sch, part in row 1, column 2]

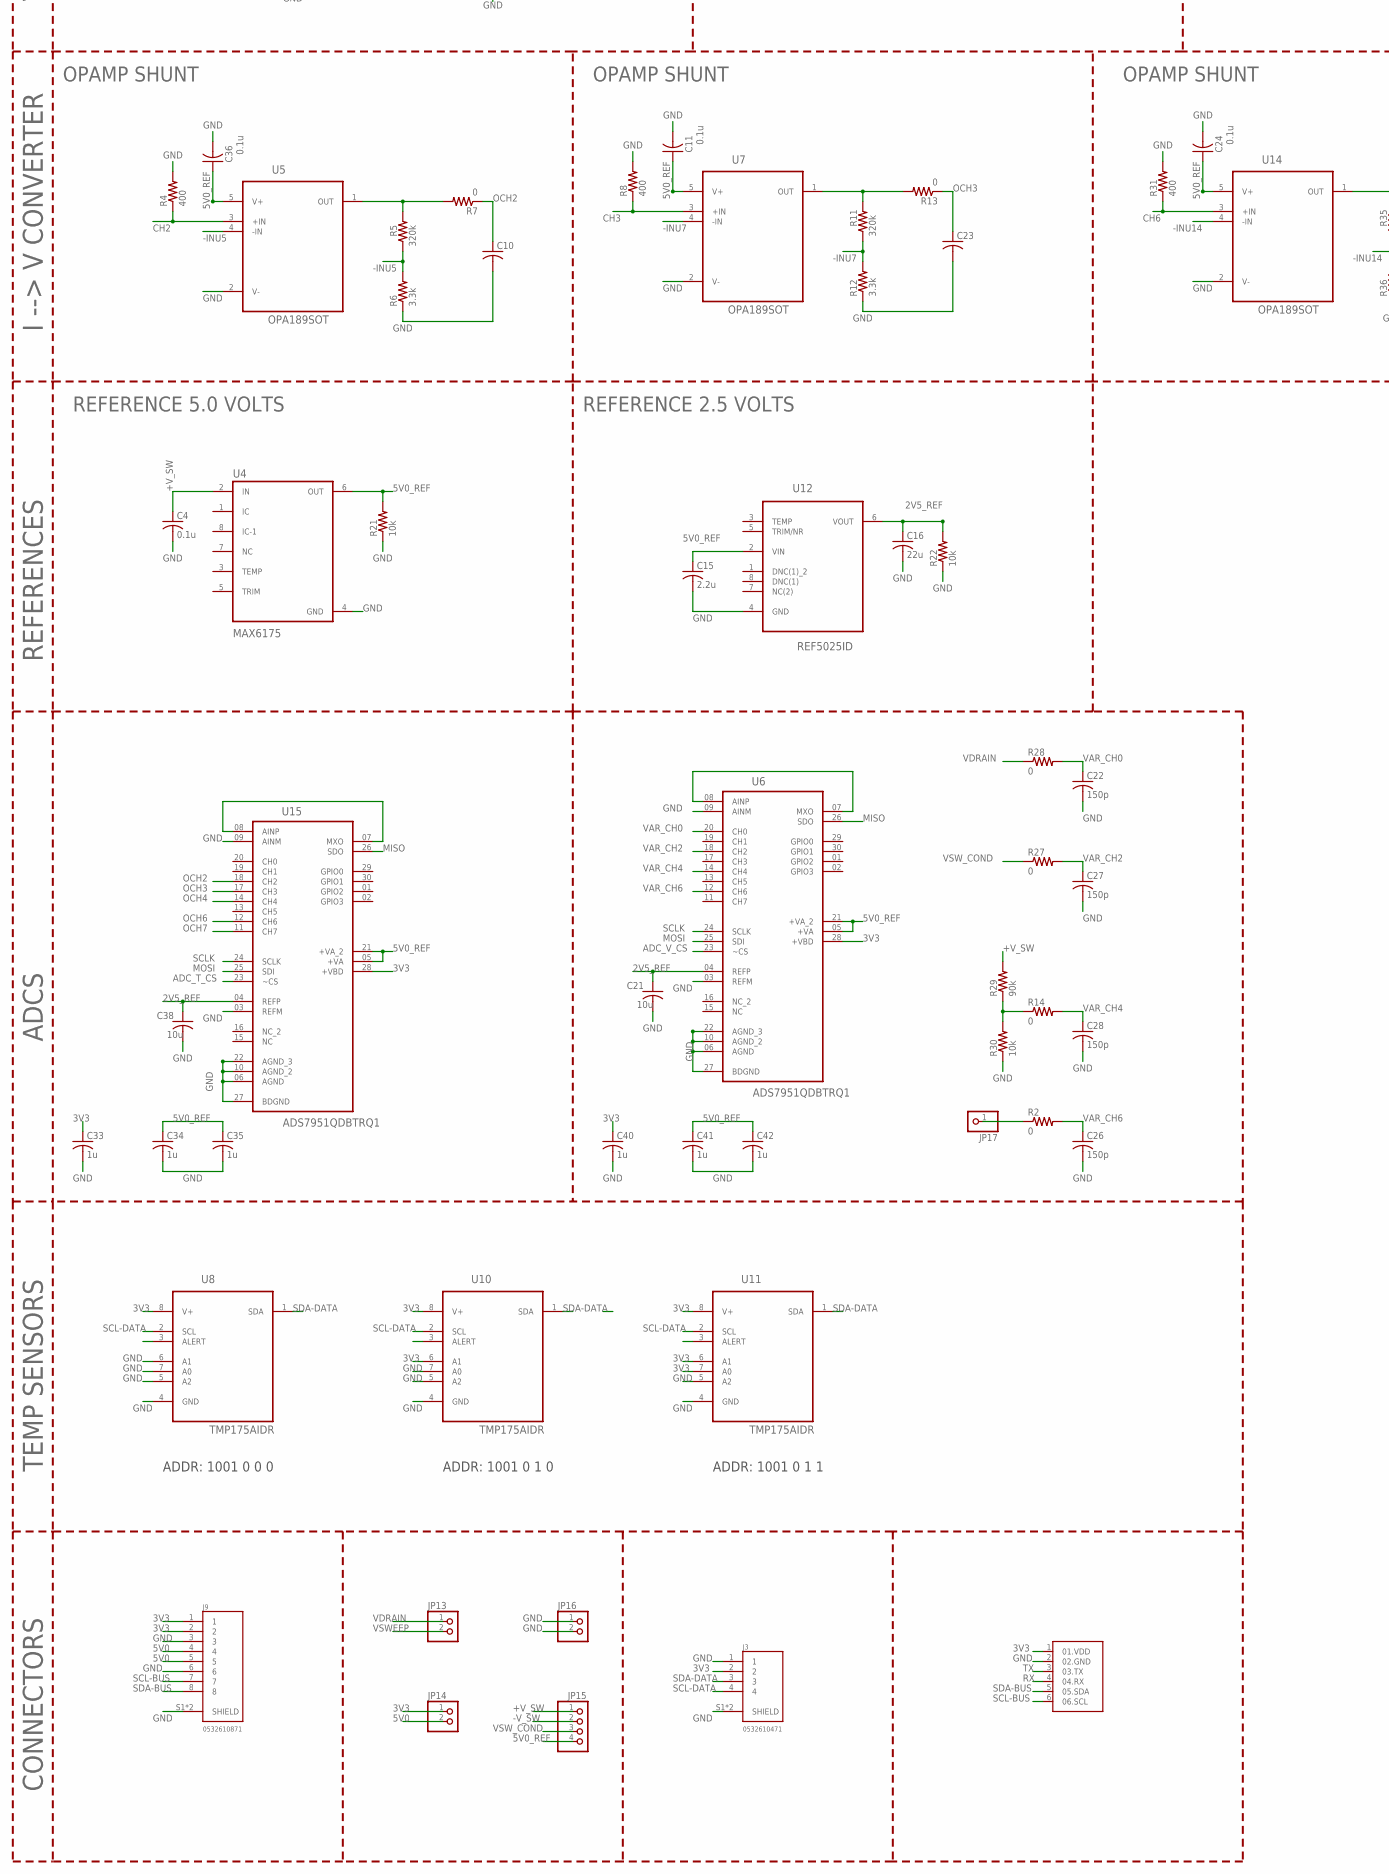
[picture p31: schematic TG_SAT_24V0_V1.4.sch, part in row 2, column 1]

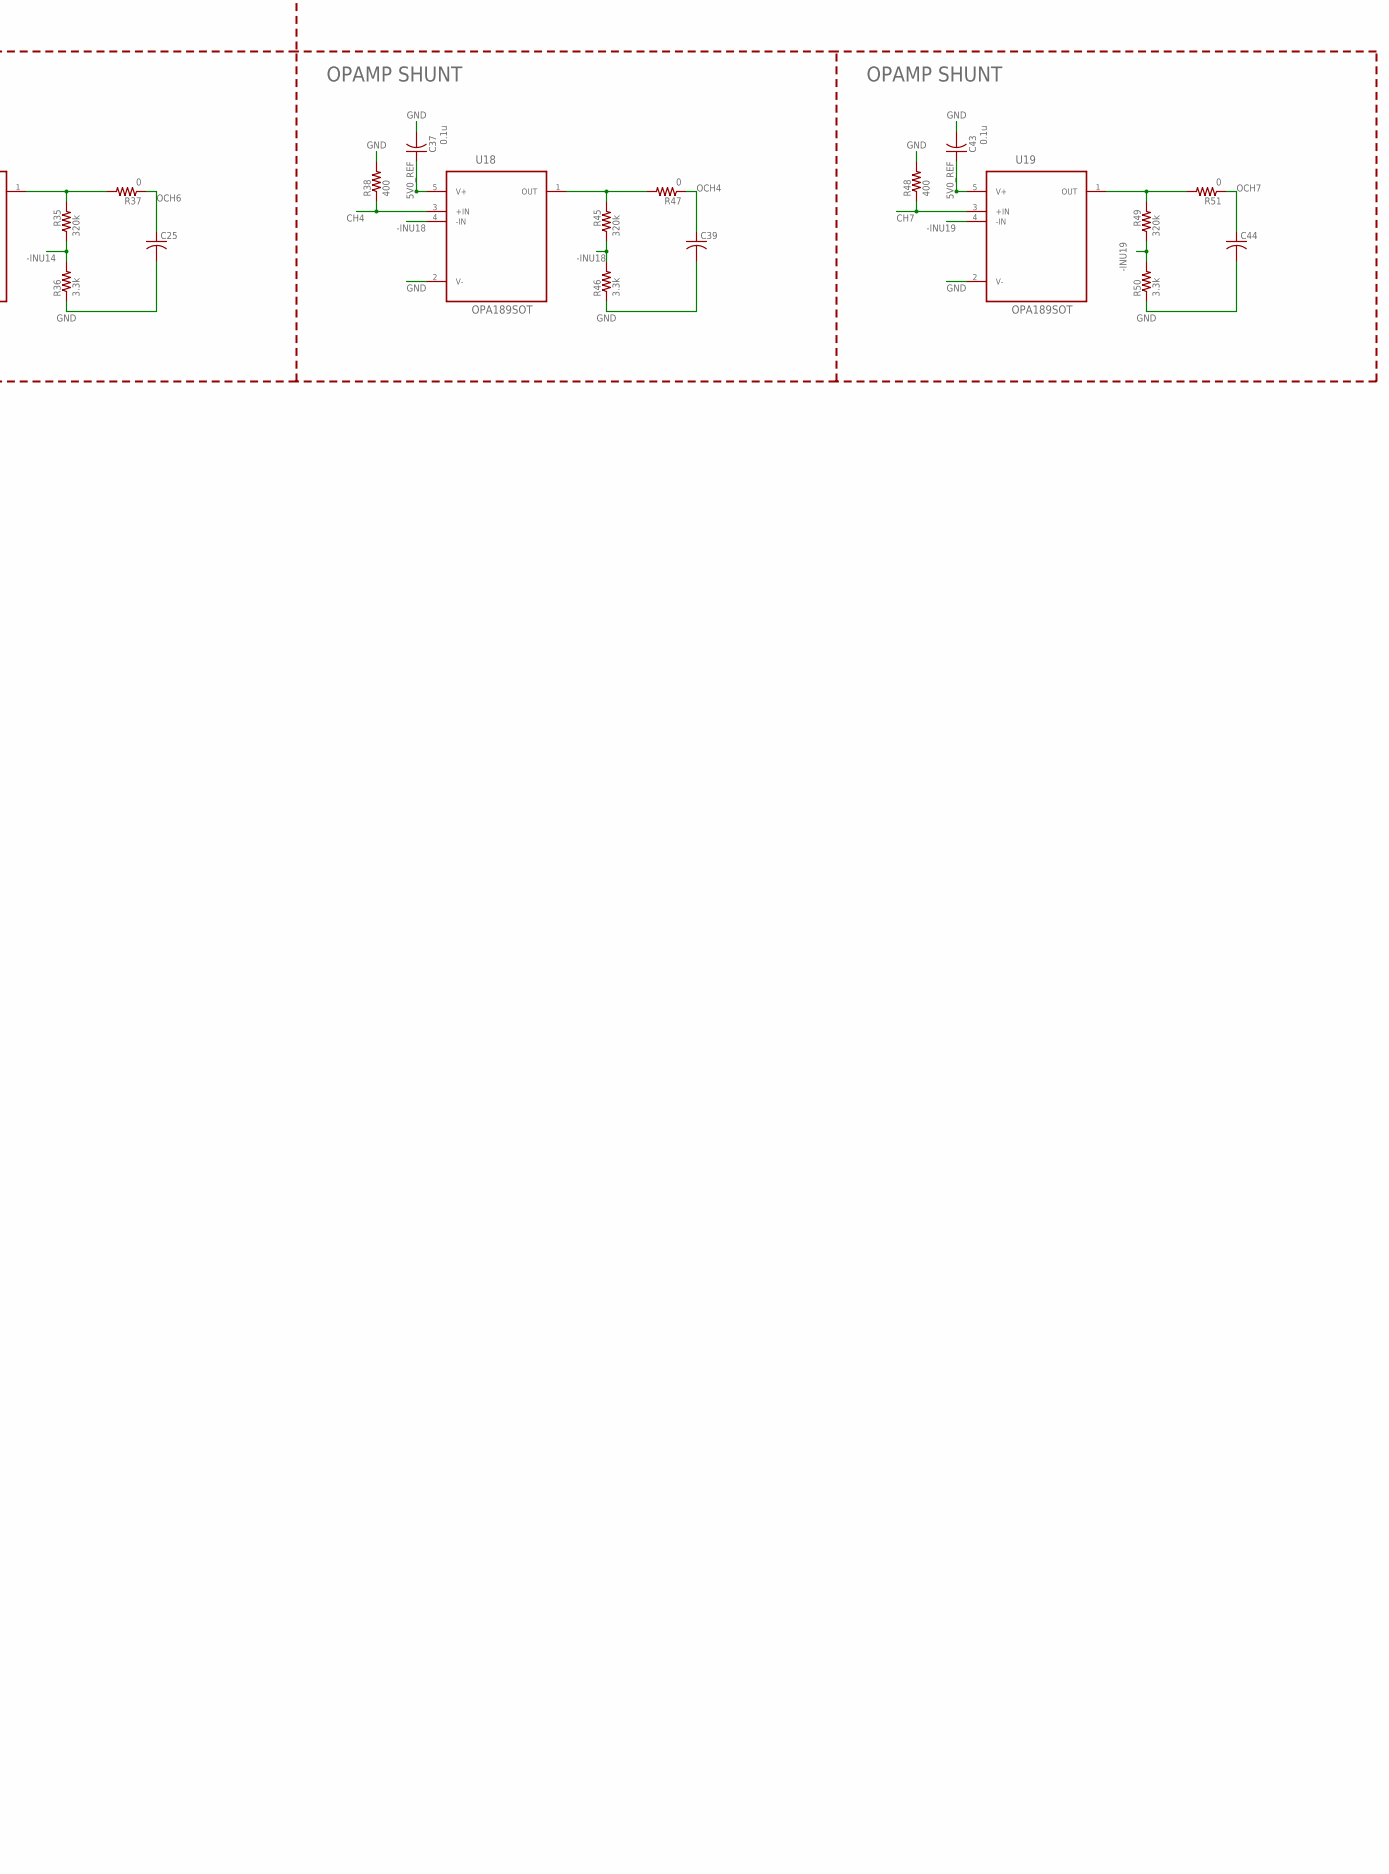
[picture p32: schematic TG_SAT_24V0_V1.4.sch, part in row 2, column 2]

Parts:
C1, C5: 4.7u; C1206
C2, C3, C33, C34, C35, C40, C41, C42: 1u; C0603
C4, C11, C24, C36, C37, C43: 0.1u; C0805
C6: 0.1u; C0603
C7: 0.022u; C0603
C8, C9, C10, C12, C23, C25, C39, C44: C-USC0603; C0603
C15: 2.2u; C1206
C16: 22u; C1206
C21, C38: 10u; C0603
C22, C26, C27, C28: 150p; C0603
J1: SUCHAI_PCB
J2: THING_PLUS
J3: 0532610471; MOLEX_0532610471
J9: 0532610871; MOLEX_0532610871
JP1, JP6: JUMPER-SMT_2_NC_PASTE_SILK; SMT-JUMPER_2_NC_PASTE_SILK
JP13, JP14, JP16: PINHD-1X2/90; 1X02/90
JP15: PINHD-1X4/90; 1X04/90
JP17: PINHD-1X1; 1X01
R1, R3, R10, R21, R22, R25, R26: 10k; R0805
R2, R7, R13, R14, R15, R27, R28, R37, R47, R51: 0; R0603
R4, R8, R31, R38, R48: 400; R0603
R5, R11, R35, R45, R49: 320k; R1206
R6, R12, R36, R46, R50: 3.3k; R0603
R9: 4.3k; R0603
R20, R23, R24: 47; R0603
R29: 90k; R0805
R30: 10k; R0603
R32: 18k; R0603
R33: 200; R0603
R34: 3.6k; R0603
R39, R40, R41, R42: 2.74k; R0603
RFB1: 17.2k; R0603
RFB2: 120k; R0805
RG1: 14,3k; R1206
RG2: 16k; R1206
U1: PES1-S5-D24-M; CONV_PES1-S5-D24-M
U2: DAC7562; SOP50P490X110-10N
U3: ADA4522; SOP65P490X110-8N
U4: MAX6175; SOIC127P600X175-8N
U5, U7, U14, U18, U19: OPA189SOT; SOT95P280X145-5N
U6, U15: ADS7951QDBTRQ1; TSSOP-30
U8, U10, U11: TMP175AIDR; SOIC127P600X175-8N
U9: RPI-ZERO; RASPBERRYPI_BASTELSTUBE_V13_RASPI_BOARD_B+_FULL
U12: REF5025ID; SOIC127P600X175-8N
U16, U17: 24LC1025T; SOIC127P599X173-8N
U$1: BRKOUT-PIC16; BKROUT-PIC16
ZX1: 232-; 3M-MOD

Connections:
2V5_REF: C16.1, C21.1, C38.1, R22.2, U6.04 (REFP), U12.6 (VOUT), U15.04 (REFP)
3V3: C33.1, C40.1, J1.24, J2.27 (3V3), J3.2, J9.1, J9.2, JP14.1, R39.2, R40.2, R41.2, R42.2, U6.28 (+VBD), U8.8 (V+), U10.6 (A1), U10.8 (V+), U11.6 (A1), U11.7 (A0), U11.8 (V+), U15.28 (+VBD), U16.3 (03.A2), U16.8 (08.VCC), U17.2 (02.A1), U17.3 (03.A2), U17.8 (08.VCC), U$1.1 (01.VDD)
5V0: C1.1, J1.50, J9.4, J9.5, JP14.2, U1.2 (VIN), U9.2 (5V0), U9.4 (5V0)
5V0_REF: C5.1, C6.1, C11.1, C15.1, C24.1, C34.1, C35.1, C36.1, C37.1, C41.1, C42.1, C43.1, JP15.4, R21.2, R34.2, U2.9 (09.AVDD), U4.6 (OUT), U5.5 (V+), U6.05 (+VA), U6.21 (+VA_2), U7.5 (V+), U12.2 (VIN), U14.5 (V+), U15.05 (+VA), U15.21 (+VA_2), U18.5 (V+), U19.5 (V+)
+V_SW: C2.1, C4.1, JP15.1, R1.2, R10.2, R29.2, U1.7 (+VO), U3.7 (VP), U4.2 (IN)
-INU5: R5.1, R6.2, U5.4 (-IN)
-INU7: R11.1, R12.2, U7.4 (-IN)
-INU14: R35.1, R36.2, U14.4 (-IN)
-INU18: R45.1, R46.2, U18.4 (-IN)
-INU19: R49.1, R50.2, U19.4 (-IN)
-V_SW: C3.1, JP15.2, R25.2, R26.2, U1.5 (-VO), U3.4 (VM)
ADC_T_CS: J2.23 (A1), U9.26 (!CE!/GPIO7), U15.23 (~CS)
ADC_V_CS: J2.3 (GPIO6), U6.23 (~CS), U9.32 (GPIO12)
AGND: J1.68
CH0: ZX1.2
CH1: ZX1.4
CH2: R4.1, U5.3 (+IN), ZX1.5
CH3: R8.1, U7.3 (+IN), ZX1.7
CH4: R38.1, U18.3 (+IN), ZX1.9
CH5: ZX1.11
CH6: R31.1, U14.3 (+IN), ZX1.13
CH7: R48.1, U19.3 (+IN), ZX1.14
CS_DAC: J2.19 (A5), U2.6 (06.~SYNC), U9.24 (!CE0!/GPIO8)
GND: C1.2, C2.2, C3.2, C4.2, C5.2, C6.2, C7.2, C8.2, C9.2, C10.2, C11.2, C12.2, C15.2, C16.2, C21.2, C22.2, C23.2, C24.2, C25.2, C26.2, C27.2, C28.2, C33.2, C34.2, C35.2, C36.2, C37.2, C38.2, C39.2, C40.2, C41.2, C42.2, C43.2, C44.2, J1.67, J1.93, J1.94, J2.25 (GND), J3.1, J3.S1 (SHIELD), J3.S2 (SHIELD), J9.3, J9.6, J9.S1 (SHIELD), J9.S2 (SHIELD), JP1.1, JP16.1, JP16.2, R1.1, R3.1, R4.2, R6.1, R8.2, R9.1, R10.1, R12.1, R21.1, R22.1, R25.1, R26.1, R30.1, R31.2, R36.1, R38.2, R46.1, R48.2, R50.1, RG2.1, U1.1 (GND), U1.4 (0V), U2.3 (03.GND), U4.4 (GND), U5.2 (V-), U6.03 (REFM), U6.06 (AGND), U6.09 (AINM), U6.10 (AGND_2), U6.22 (AGND_3), U6.27 (BDGND), U7.2 (V-), U8.4 (GND), U8.5 (A2), U8.6 (A1), U8.7 (A0), U9.6 (GND), U9.9 (GND), U9.14 (GND), U9.20 (GND), U9.25 (GND), U9.30 (GND), U9.34 (GND), U9.39 (GND), U10.4 (GND), U10.5 (A2), U10.7 (A0), U11.4 (GND), U11.5 (A2), U12.4 (GND), U14.2 (V-), U15.03 (REFM), U15.06 (AGND), U15.09 (AINM), U15.10 (AGND_2), U15.22 (AGND_3), U15.27 (BDGND), U16.1 (01.A0), U16.2 (02.A1), U16.4 (04.VSS), U16.7 (07.WP), U17.1 (01.A0), U17.4 (04.VSS), U17.7 (07.WP), U18.2 (V-), U19.2 (V-), U$1.2 (02.GND)
MISO: R20.2, U6.26 (SDO), U15.26 (SDO)
MISO_C: J2.16 (MISO), R20.1, U9.21 (GPIO9/MISO)
MOSI: R24.2, U2.8 (08.DIN), U6.25 (SDI), U15.25 (SDI)
MOSI_C: J2.17 (MOSI), R24.1, U9.19 (GPIO10/MOSI)
unnamed: RFB1.1, RFB2.2
unnamed: R9.2, R33.1
unnamed: R5.2, R7.2, U5.1 (OUT)
unnamed: U6.07 (MXO), U6.08 (AINP)
unnamed: R11.2, R13.2, U7.1 (OUT)
unnamed: R35.2, R37.2, U14.1 (OUT)
unnamed: JP1.2, U2.4 (04.~LDAC)
unnamed: R14.1, R29.1, R30.2
unnamed: JP17.1, R2.1
unnamed: R45.2, R47.2, U18.1 (OUT)
unnamed: RFB2.1, RG1.2, RG2.2, U3.2 (M)
unnamed: R49.2, R51.2, U19.1 (OUT)
unnamed: U15.07 (MXO), U15.08 (AINP)
OCH2: C10.1, R7.1, U15.18 (CH2)
OCH3: C23.1, R13.1, U15.17 (CH3)
OCH4: C39.1, R47.1, U15.14 (CH4)
OCH6: C25.1, R37.1, U15.12 (CH6)
OCH7: C44.1, R51.1, U15.11 (CH7)
REF_DAC: C7.1, RG1.1, U2.10 (10.VREFIN/OUT)
RX: J2.15 (RX), U9.10 (RXD0/GPIO15), U$1.4 (04.RX)
SCL-BUS: J1.22, J2.2 (SCL), J9.7, R42.1, U9.5 (GPIO3/SCL1), U$1.6 (06.SCL)
SCL-DATA: J2.8 (GPIO1), J2.9 (GPIO0), J3.4, R40.1, U8.2 (SCL), U9.18 (GEN5/GPIO24), U10.2 (SCL), U11.2 (SCL), U16.6 (06.SCL), U17.6 (06.SCL)
SCLK: R23.2, U2.7 (07.SCLK), U6.24 (SCLK), U15.24 (SCLK)
SCLK_C: J2.18 (SCK), R23.1, U9.23 (GPIO11/SCLK)
SDA-BUS: J1.21, J2.1 (SDA), J9.8, R41.1, U9.3 (GPIO2/SDA1), U$1.5 (05.SDA)
SDA-DATA: J2.7 (GPIO2), J3.3, R39.1, U8.1 (SDA), U9.16 (GEN4/GPIO23), U10.1 (SDA), U11.1 (SDA), U16.5 (05.SDA), U17.5 (05.SDA)
TX: J2.14 (TX), U9.8 (TXD0/GPIO14), U$1.3 (03.TX)
VAR_CH0: C22.1, R28.2, U6.20 (CH0)
VAR_CH2: C27.1, R27.2, U6.18 (CH2)
VAR_CH4: C28.1, R14.2, U6.14 (CH4)
VAR_CH6: C26.1, R2.2, U6.12 (CH6)
VDRAIN: JP6.2, JP13.1, R28.1, ZX1.27, ZX1.29
VOUTA: C8.1, U2.1 (01.VOUTA), U3.3
VOUTB: C9.1, JP6.1, U2.2 (02.VOUTB)
VOUT_SW: C12.1, R3.2, R15.2, RFB1.2, U3.6 (OUT)
VSWEEP: JP13.2, R15.1, R32.2, ZX1.21, ZX1.23
VSW_COND: JP15.3, R27.1, R32.1, R33.2, R34.1

Notes on the sheet:
DC-DC
SUCHAI PAYLOAD PCB
PROCESSOR
CHIP HOLDER
+V/-V
DAC + OPAMP
VOLTAGE SWEEP
OPAMP SHUNT
I --> V CONVERTER
REFERENCE 5.0 VOLTS
REFERENCE 2.5 VOLTS
VSWEEP CONDITIONING
REFERENCES
VDRAIN
ADCS
TEMP SENSORS
ADDR: 1001 0 0 0
ADDR: 1001 0 1 0
ADDR: 1001 0 1 1
CONNECTORS
ADDRESS: 1 0 1 0 X 1 0 bo = 0 -> 52 bo = 1 -> 56
ADDRESS: 1 0 1 0 X 0 0 bo = 0 -> 50 b1 = 1 -> 54

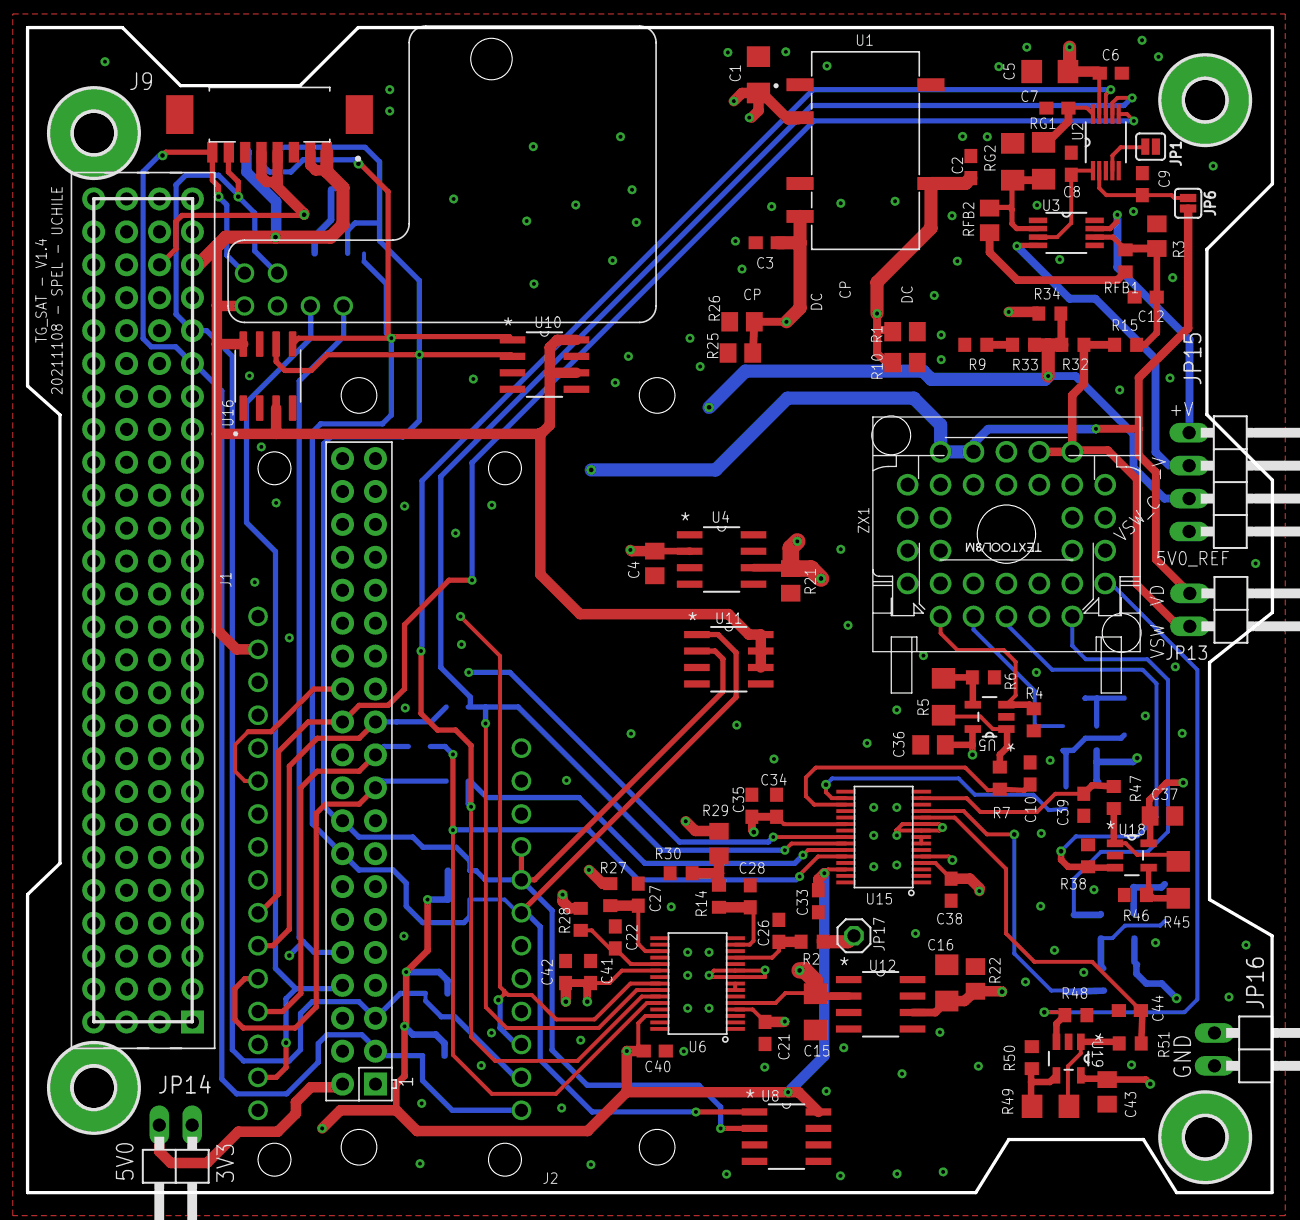
[picture p33: board TG_SAT_24V0_V1.4.brd from above]

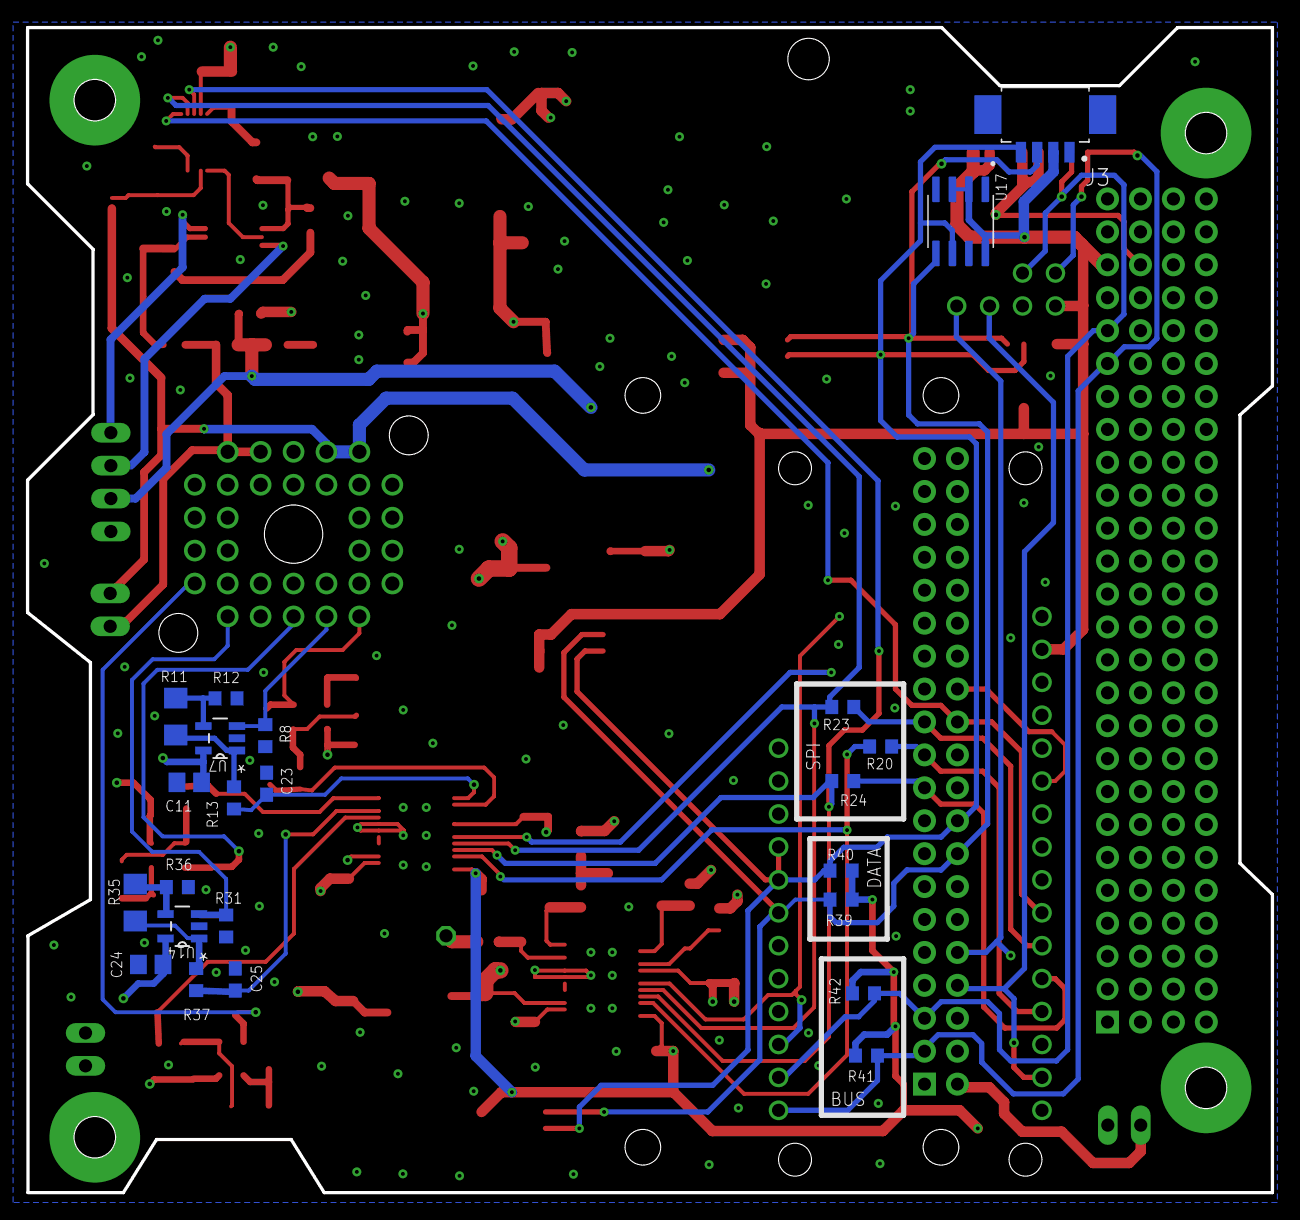
[picture p34: board TG_SAT_24V0_V1.4.brd from below]

Board: 4 copper layers, 96.2 x 90.0 mm, 114 parts (23 on the bottom side), 61 nets.
