spel-uchile/S2_S3_PS_MAG_PCBs/PC104 - plansat/MAG_plus/magnetometro.ino

/*
 * Rui Santos 
 * Complete Project Details https://randomnerdtutorials.com
*/

#include <Wire.h>
#include <Adafruit_BMP085.h>

Adafruit_BMP085 bmp;
  
void setup() {
  Serial.begin(9600);
  if (!bmp.begin()) {
  Serial.println("Could not find a valid BMP085/BMP180 sensor, check wiring!");
  while (1) {}
  }
}
  
void loop() {
  Serial.print("Temperature = ");
  Serial.print(bmp.readTemperature());
  Serial.println(" *C");
    
  Serial.print("Pressure = ");
  Serial.print(bmp.readPressure());
  Serial.println(" Pa");
    
  // Calculate altitude assuming 'standard' barometric
  // pressure of 1013.25 millibar = 101325 Pascal
  Serial.print("Altitude = ");
  Serial.print(bmp.readAltitude());
  Serial.println(" meters");

  Serial.print("Pressure at sealevel (calculated) = ");
  Serial.print(bmp.readSealevelPressure());
  Serial.println(" Pa");

  // you can get a more precise measurement of altitude
  // if you know the current sea level pressure which will
  // vary with weather and such. If it is 1015 millibars
  // that is equal to 101500 Pascals.
  Serial.print("Real altitude = ");
  Serial.print(bmp.readAltitude(102000));
  Serial.println(" meters");
    
  Serial.println();
  delay(500);
}
